Ilgneous/RipWing/ripwing/README.md

# RipWing

Fault-tolerant quadcopter flight controller with edge-deployed anomaly
detection. Firmware in Rust on STM32, scheduled with RTIC. Control logic is
pure and host-testable, validated against a Python simulator before it
reaches hardware.

## Workspace layout

    crates/common     Shared data types. no_std, no HAL. Host + target.
    crates/control    Pure control math (PID, mixer, Controller trait).
                      no_std, host-testable. Depends only on `common`.
    crates/filter     Sensor conditioning: median-of-3 spike rejection into
                      an N-tap moving average. no_std, host-testable.
    crates/estimation Attitude estimation: quaternion complementary filter
                      behind an AttitudeEstimator trait (EKF later).
                      no_std, host-testable.
    crates/safety     Failsafe state machine and safety checks. no_std,
                      host-testable. Depends only on `common`.
    crates/sensors    BMI088, BMP581, MMC5983MA chip drivers on the
                      embedded-hal 1.0 traits. no_std, no HAL, host-tested
                      against register-level fakes.
    firmware          RTIC binary for the STM32F411. Depends on the crates,
                      adds the HAL, drivers, scheduler, and DShot output.

The dependency graph enforces the layering (case study §3.1): `control`
cannot reach a HAL or RTIC type because it does not depend on them, so
"keep control logic host-testable" is a structural fact, not a discipline.

## Build & test

Host-testable control logic (no hardware needed):

    cargo test -p ripwing-control
    cargo test -p ripwing-filter
    cargo test -p ripwing-estimation
    cargo test -p ripwing-safety
    cargo test -p ripwing-sensors
    cargo test -p ripwing-common

Firmware (cross-compiles to ARM; needs the target installed):

    cargo fw          # alias: build -p ripwing-firmware --target thumbv7em-none-eabihf
    cargo rfw         # alias: run   (flash + stream defmt logs) — needs a probe

Toolchain setup:

    rustup target add thumbv7em-none-eabihf
    cargo install probe-rs-tools --locked
    cargo install flip-link

## Target

- Bring-up: STM32F411CEUx (WeAct BlackPill), 25 MHz HSE.
- Planned: STM32H743 (ML compute headroom) on a custom PCB.

## Status

- Scheduler: six-task RTIC graph at rate-monotonic priorities. Done.
- Control crate: two-stage cascade. The outer attitude loop (P per axis,
  shortest-way heading error, rate-demand clamp, tilt-compensated thrust)
  feeds the rate-loop PIDs (anti-windup, derivative-on-measurement
  filtering), then the quad-X mixer (body FLU frame). The firmware runs
  both stages per IMU sample from an `AttitudeSetpoint`, which stays level
  at zero thrust until the RC driver writes it. Heading hold follows the
  estimator's gyro-only yaw, so it drifts with gyro bias until there is a
  magnetometer or EKF. Cross-checked against QuadSim:
  a Rust port of the 10-DOF plant's rotational dynamics matches the Python
  to ~1e-15, and the firmware controller reproduces QuadSim's tuned step
  responses on it, roll, pitch and yaw, at 200 Hz and at the firmware's
  1 kHz, and large steps QuadSim never tested settle without overshoot
  (`crates/control/tests/quadsim_*.rs`). The firmware flies QuadSim's
  tuned gains (`crates/control/src/gains.rs`); a test fails if they drift
  from the tune. Regenerate the reference data with
  `python -m QuadSim.analysis.export_step_references` from the repo root
  after changing the Python plant, controller or gains.
- Safety crate: failsafe state machine (Disarmed/Armed/Failsafe, latched)
  with staleness, attitude, rate and RC-link checks, plus a battery
  monitor; 45 host tests. Wired into the priority-6 task; gates the control
  output.
  - Battery reading: the safety task reads its own ADC (pack voltage
    through the ÷11 divider, ESC current sense), non-blocking at 500 Hz per
    channel, against a VDDA measured at boot.
  - Battery judging: levels use a sag-filtered voltage with a 2 s hold, so
    throttle sag never raises a warning. Cell count is detected at connect,
    and mAh is counted.
  - Battery policy: low battery refuses arming. In flight, Low and Critical
    are warnings only, never a motor cut (there is no auto-land, so a cut
    is a crash).
  - The current sensor's scale in `board.rs` is a placeholder until the
    ESC is chosen.
  - The RC-link input is still a placeholder until that driver exists.
- Filter crate: median-then-average sensor conditioning with documented
  lag-versus-noise tradeoff, plus a noise meter. Wired in at the IMU
  driver boundary (gyro N=2, accel N=8): raw samples are logged, filtered
  samples go downstream.
- IMU: ICM-42688-P on SPI1 with DMA. The control chain is sensor-driven:
  data-ready -> DMA burst read -> fusion -> control, each stage spawned by
  the previous one. Transfers overlap computation. The safety monitor stays
  on SysTick so it can detect a dead sensor chain.
- Estimation crate: quaternion complementary filter (τ = 1 s, accel norm
  gate, seeded from accel at boot) with the magnetometer and barometer
  fused, 40 host tests.
  - Heading: a tilt-compensated magnetometer correction about the world
    vertical only (τ = 5 s), so the magnetometer can never disturb roll or
    pitch. It snaps to the magnetometer once at boot and gates on field
    strength. It applies declination and hard/soft-iron calibration, both
    set in `board.rs`; calibration is not yet measured.
  - Altitude: a third-order complementary filter of baro height and
    world-frame vertical acceleration (τ = 2 s), which learns accel bias.
    It reports height above the boot pressure and climb rate in
    `StateEstimate::vertical`.
  - Each output is withdrawn if its sensor stops for 0.5 s.
- Sensors crate: BMI088 (IMU2), BMP581 baro and MMC5983MA mag drivers on
  embedded-hal 1.0, so they run on the F411 now and the H723 PCB later.
  Host tests run against register-level fakes of each chip. The firmware
  polls them at 500/50/100 Hz, on the PCB's SPI2 and I2C1 pins. Each one is
  optional at boot (probed by chip ID), and a sensor that keeps failing is
  dropped. The magnetometer and barometer feed the estimator.
- Next: bench-verify the IMU path on hardware and measure noise with motors
  spinning; magnetometer hard/soft-iron calibration of the assembled
  airframe; RC driver writing the attitude setpoint, capturing the heading
  at arming, and a rate/acro mode that bypasses the outer loop; EKF.

## Design notes

- Control loop is highest priority after the safety monitor; ML inference
  and telemetry are lower and may be preempted.
- ML monitors and flags; classical control retains flight-critical
  actuation. The severity flag is a single lock-free atomic the control
  loop reads each cycle.
- The Controller trait is the firmware/control seam: swap in an MPC later
  by implementing the trait, without touching the firmware.
