Ilgneous/RipWing/Schematic preview.png

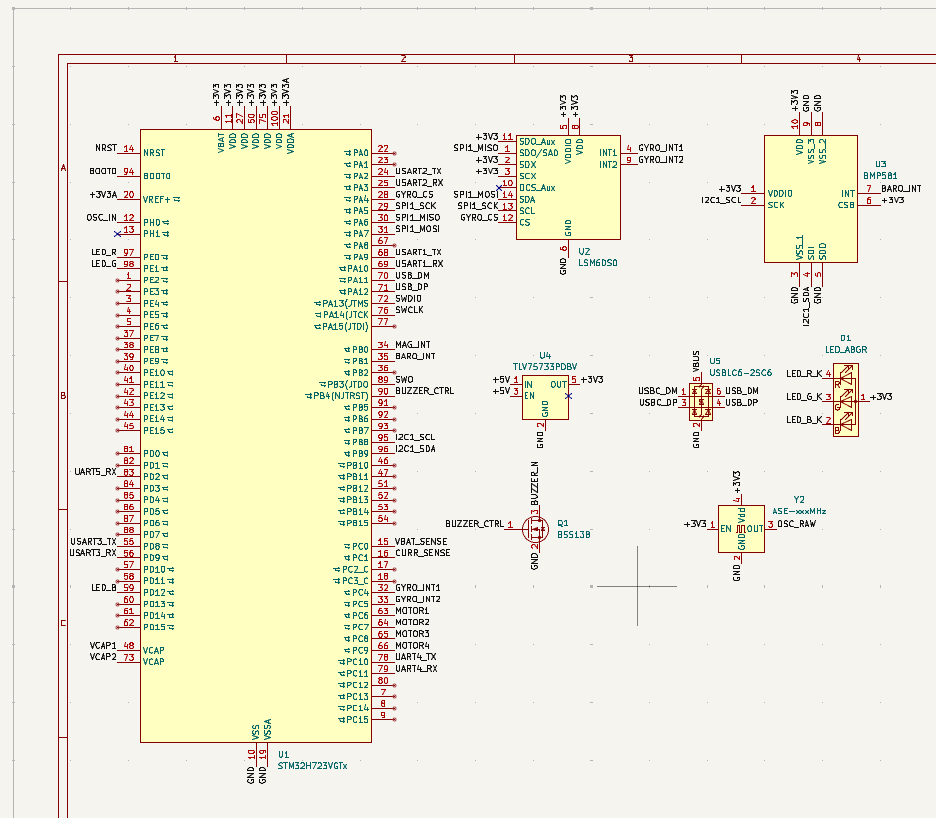
Schematic preview.png
