Ilgneous/RipWing/QuadSim/results/figures/diagnostics.png

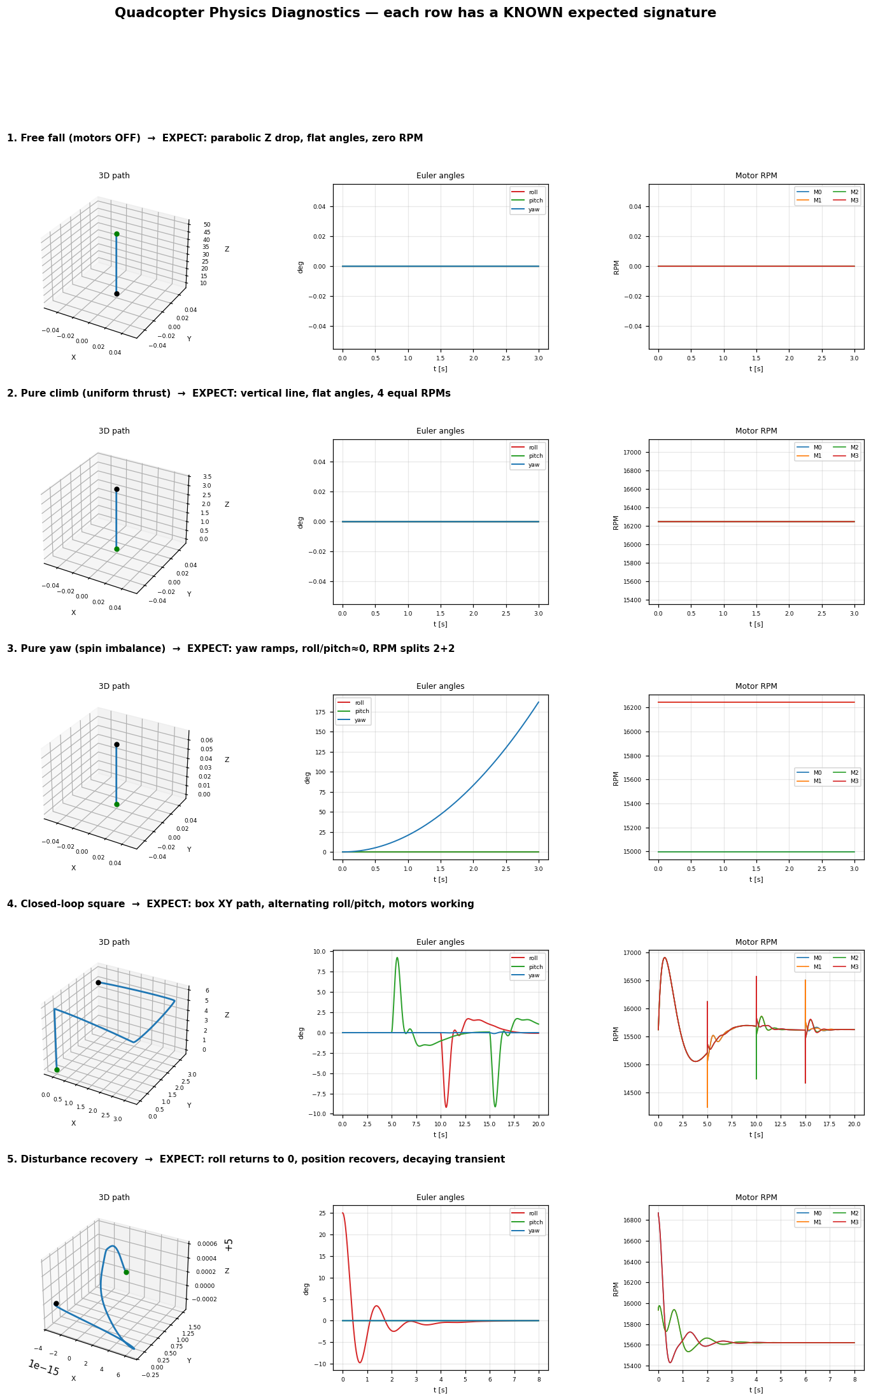
QuadSim/results/figures/diagnostics.png
