Ilgneous/RipWing/QuadSim/results/figures/ground_effect_study.png

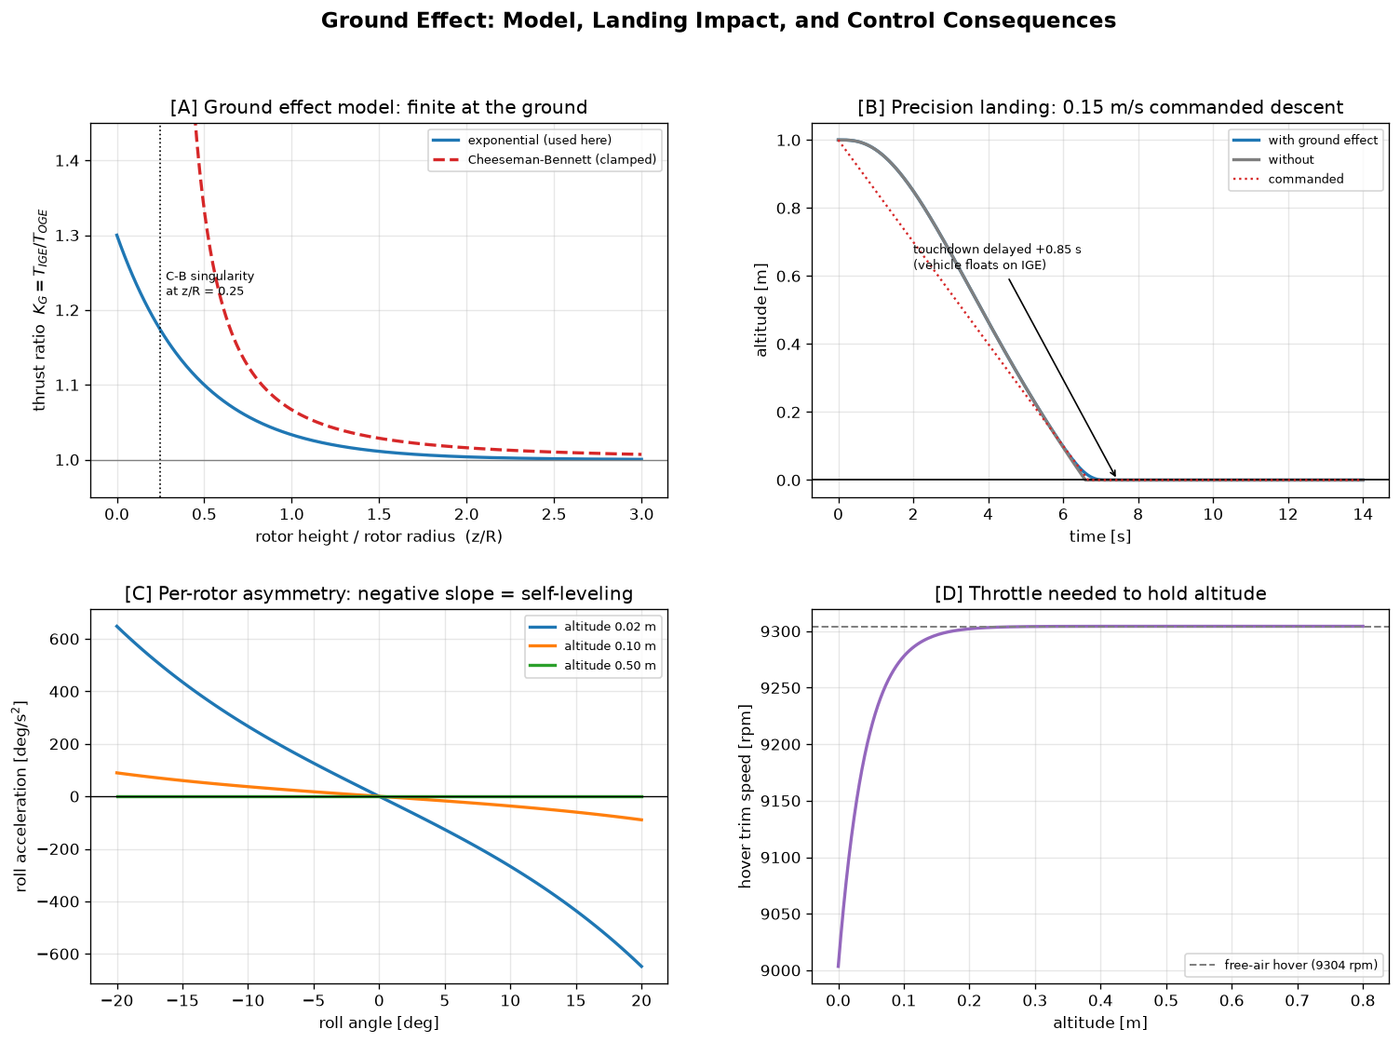
QuadSim/results/figures/ground_effect_study.png
