Ilgneous/RipWing/QuadSim/results/figures/model_comparison.png

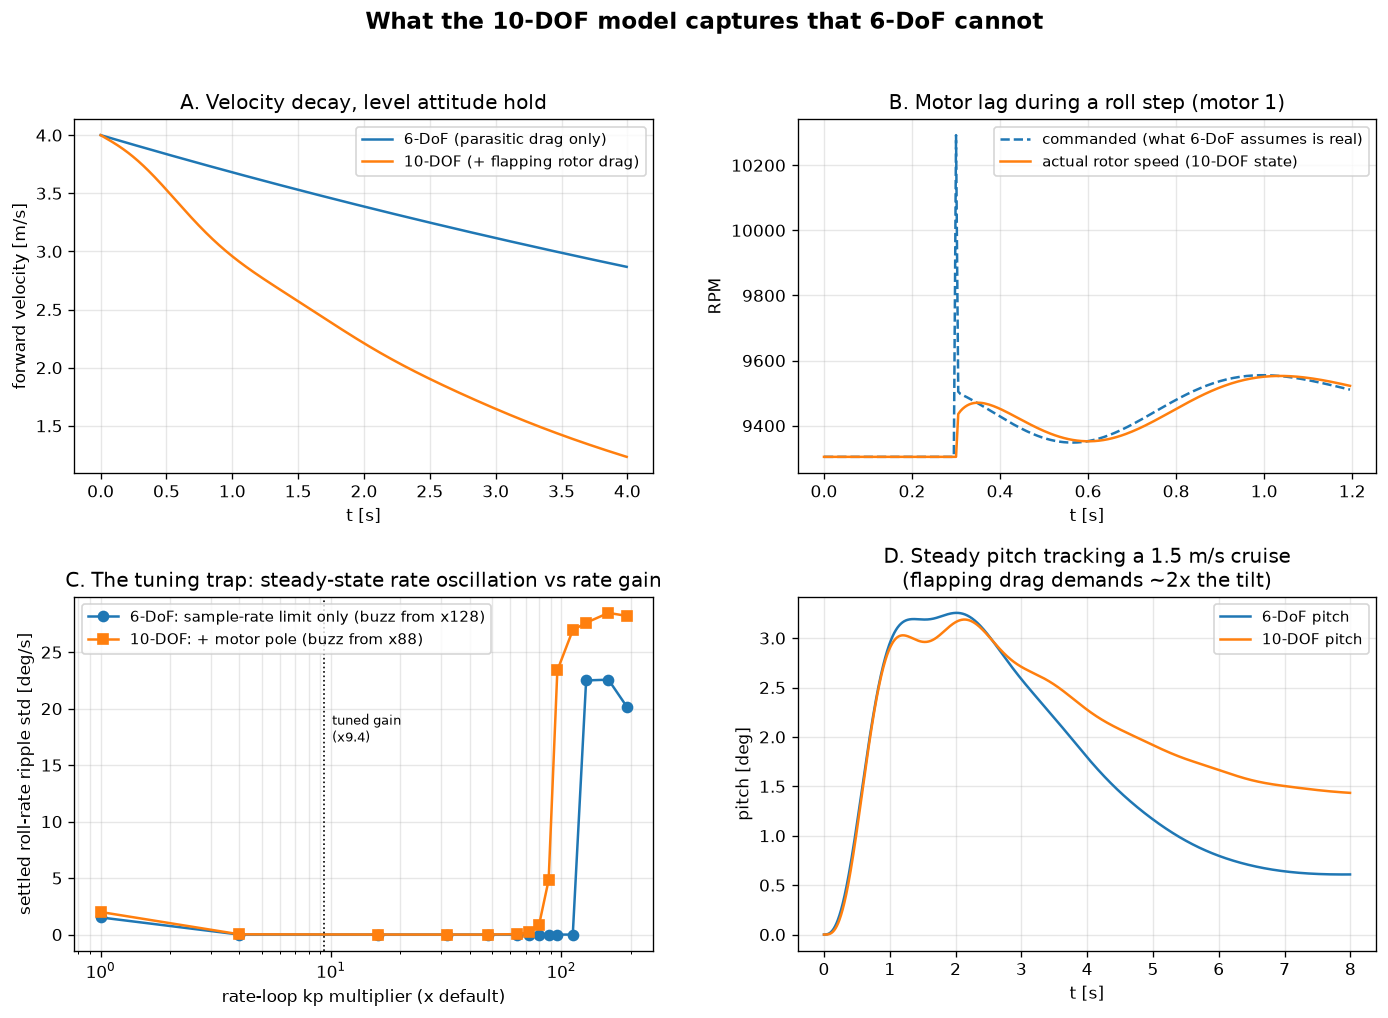
QuadSim/results/figures/model_comparison.png
