Ilgneous/RipWing/QuadSim/results/figures/tuning_comparison.png

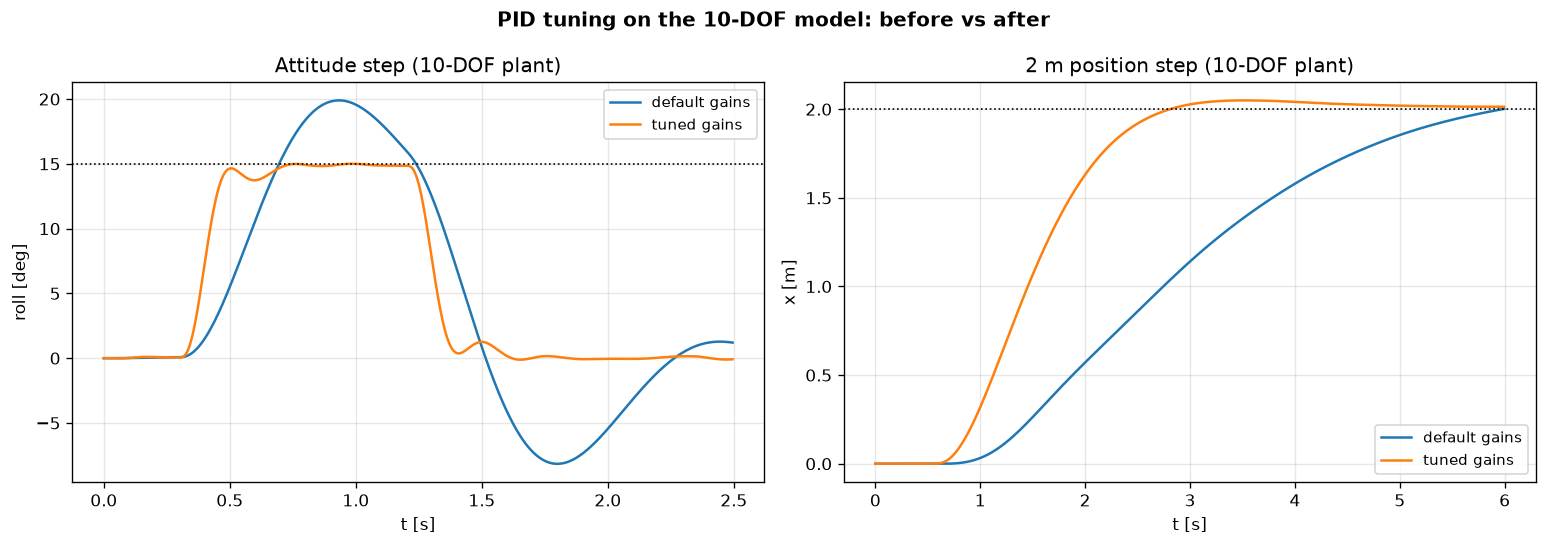
QuadSim/results/figures/tuning_comparison.png
