Ilgneous/RipWing/QuadSim/results/figures/yaw_tuning.png

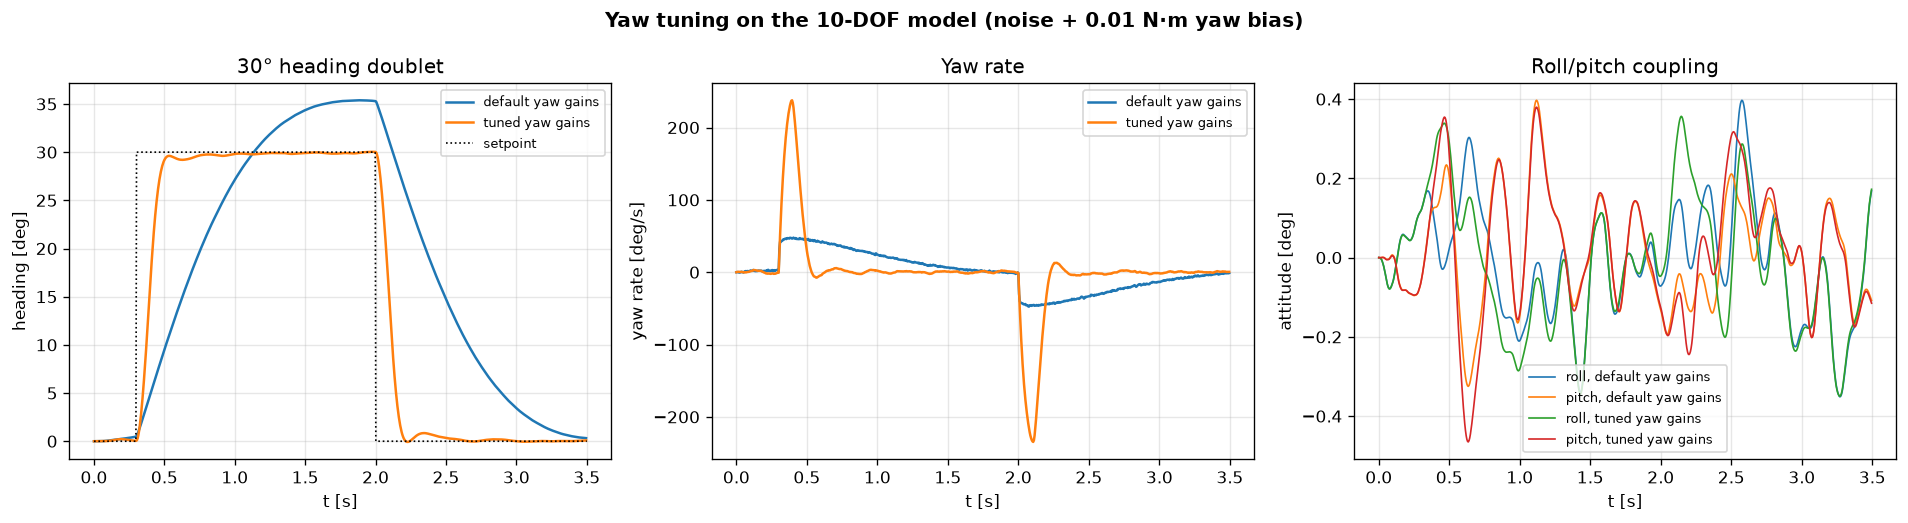
QuadSim/results/figures/yaw_tuning.png
