Ilgneous/RipWing/Ripwing.kicad_sch

## KiCad design Ripwing.kicad_sch (2026-09-10)

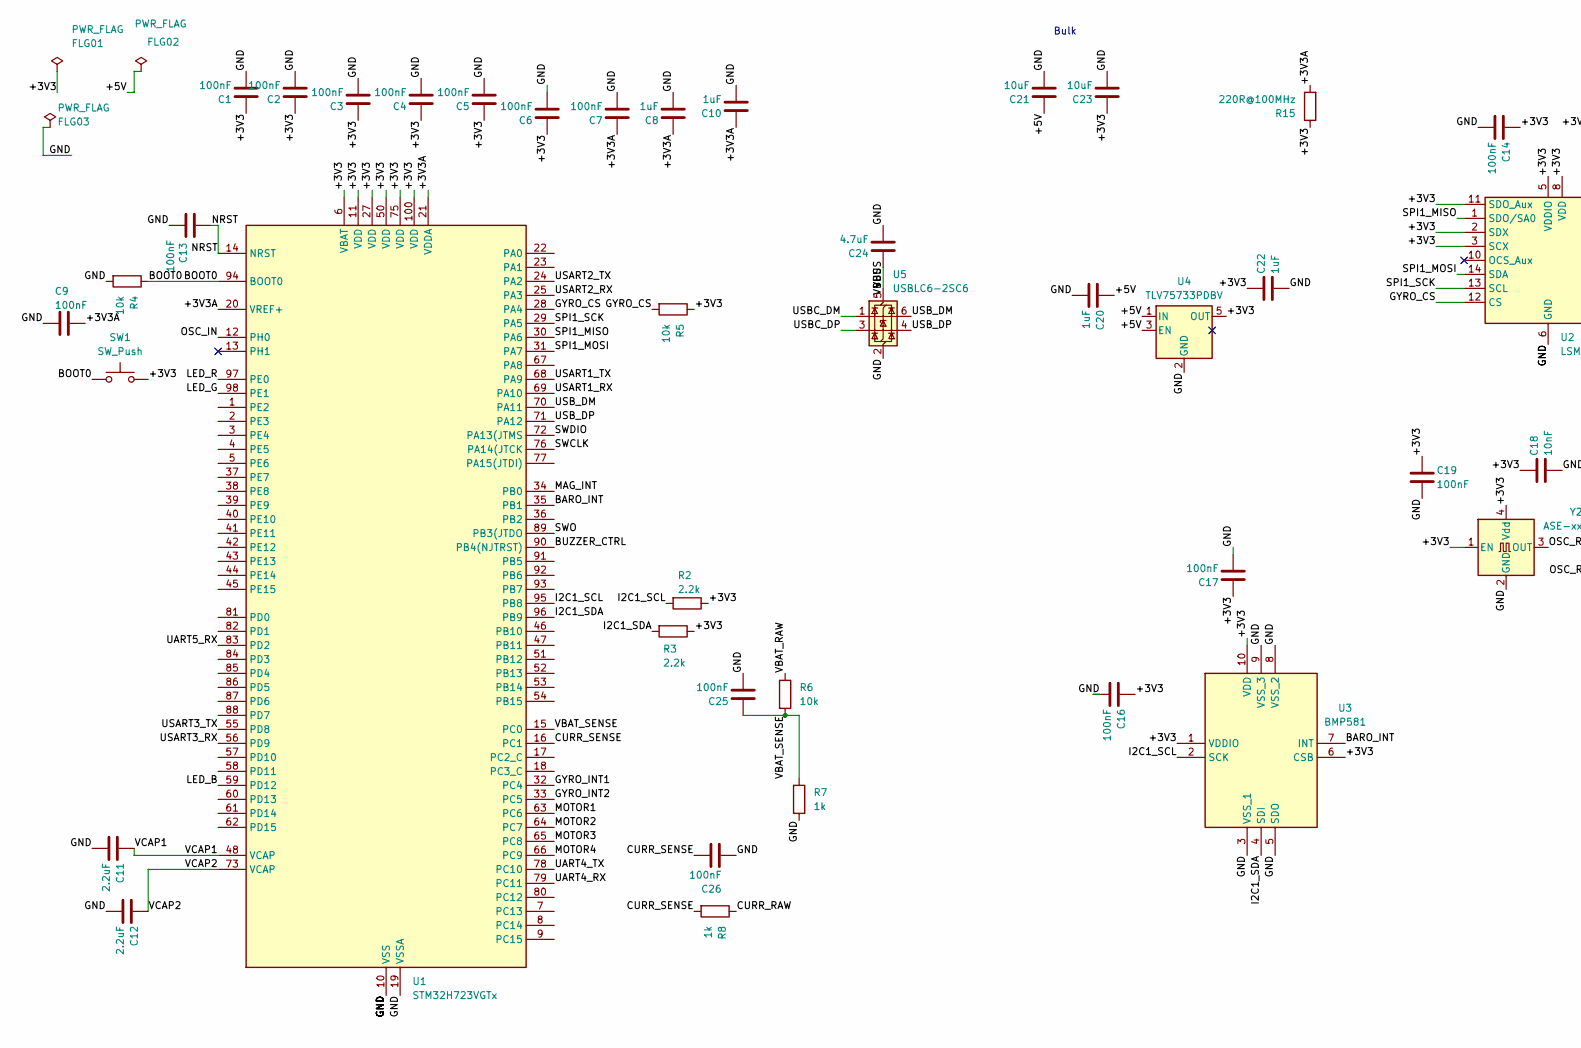
[picture p7: schematic Ripwing.kicad_sch, part in row 1, column 1]

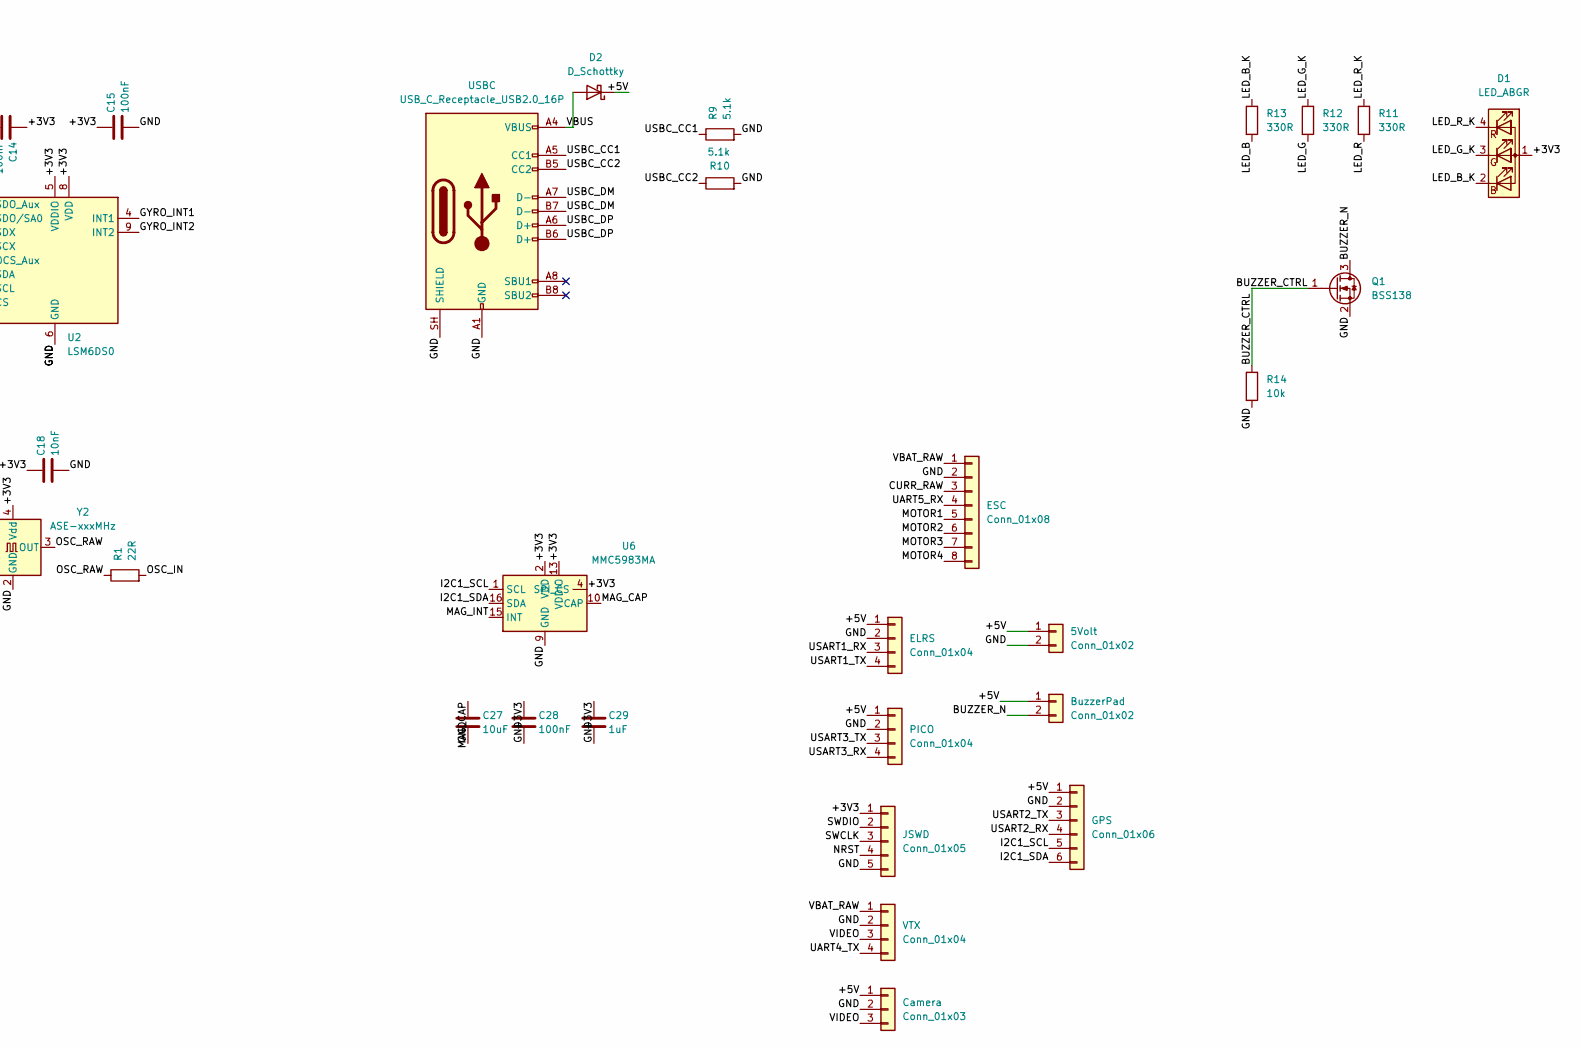
[picture p8: schematic Ripwing.kicad_sch, part in row 1, column 2]

Parts:
5Volt: Conn_01x02
BuzzerPad: Conn_01x02
C1, C2, C3, C4, C5, C6, C7, C9, C13, C14, C15, C16, C17, C19, C25, C26, C28: 100nF
C8, C10, C20, C22, C29: 1uF
C11, C12: 2.2uF
C18: 10nF
C21, C23, C27: 10uF
C24: 4.7uF
Camera: Conn_01x03
D1: LED_ABGR
D2: D_Schottky
ELRS: Conn_01x04
ESC: Conn_01x08
FLG01, FLG02, FLG03: PWR_FLAG
GPS: Conn_01x06
JSWD: Conn_01x05
PICO: Conn_01x04
Q1: BSS138; SOT-23
R1: 22R
R2, R3: 2.2k
R4, R5, R6, R14: 10k
R7, R8: 1k
R9, R10: 5.1k
R11, R12, R13: 330R
R15: 220R@100MHz
SW1: SW_Push
U1: STM32H723VGTx; LQFP-100_14x14mm_P0.5mm
U2: LSM6DS0; LGA-14_3x2.5mm_P0.5mm_LayoutBorder3x4y
U3: BMP581; Mouser Part Number 262-BMP581
U4: TLV75733PDBV; SOT-23-5
U5: USBLC6-2SC6; SOT-23-6
U6: MMC5983MA; LGA-16_3x3mm_P0.5mm
USBC: USB_C_Receptacle_USB2.0_16P
VTX: Conn_01x04
Y2: ASE-xxxMHz; Oscillator_SMD_Abracon_ASE-4Pin_3.2x2.5mm

Connections:
+3V3: C1.1, C2.1, C3.1, C4.1, C5.1, C6.1, C14.1, C15.1, C16.1, C17.1, C18.1, C19.1, C22.1, C23.1, C28.1, C29.1, D1.1 (A), FLG01.1, JSWD.1, R2.1, R3.1, R5.1, R15.1, SW1.2, U1.6 (VBAT), U1.11 (VDD), U1.27 (VDD), U1.50 (VDD), U1.75 (VDD), U1.100 (VDD), U2.2 (SDX), U2.3 (SCX), U2.5 (VDDIO), U2.8 (VDD), U2.11 (SDO_Aux), U3.1 (VDDIO), U3.6 (CSB), U3.10 (VDD), U4.5 (OUT), U6.2 (VDD), U6.4 (SPI_CS), U6.13 (VDDIO), Y2.1 (EN), Y2.4 (Vdd)
+3V3A: C7.1, C8.1, C9.1, C10.1, R15.2, U1.20 (VREF+), U1.21 (VDDA)
+5V: 5Volt.1, BuzzerPad.1, C20.1, C21.1, Camera.1, D2.1 (K), ELRS.1, FLG02.1, GPS.1, PICO.1, U4.1 (IN), U4.3 (EN)
BARO_INT: U1.35 (PB1), U3.7 (INT)
BOOT0: R4.1, SW1.1, U1.94 (BOOT0)
BUZZER_CTRL: Q1.1 (G), R14.1, U1.90 (PB4(NJTRST))
BUZZER_N: BuzzerPad.2, Q1.3 (D)
CURR_RAW: ESC.3, R8.1
CURR_SENSE: C26.1, R8.2, U1.16 (PC1)
GND: 5Volt.2, C1.2, C2.2, C3.2, C4.2, C5.2, C6.2, C7.2, C8.2, C9.2, C10.2, C11.2, C12.2, C13.2, C14.2, C15.2, C16.2, C17.2, C18.2, C19.2, C20.2, C21.2, C22.2, C23.2, C24.2, C25.2, C26.2, C27.2, C28.2, C29.2, Camera.2, ELRS.2, ESC.2, FLG03.1, GPS.2, JSWD.5, PICO.2, Q1.2 (S), R4.2, R7.2, R9.2, R10.2, R14.2, U1.10 (VSS), U1.19 (VSSA), U1.26 (VSS), U1.49 (VSS), U1.74 (VSS), U1.99 (VSS), U2.6 (GND), U2.7 (GND), U3.3 (VSS_1), U3.5 (SDO), U3.8 (VSS_2), U3.9 (VSS_3), U4.2 (GND), U5.2 (GND), U6.9 (GND), U6.11 (GND), USBC.A1 (GND), USBC.A12 (GND), USBC.B1 (GND), USBC.B12 (GND), USBC.SH (SHIELD), VTX.2, Y2.2 (GND)
GYRO_CS: R5.2, U1.28 (PA4), U2.12 (CS)
GYRO_INT1: U1.32 (PC4), U2.4 (INT1)
GYRO_INT2: U1.33 (PC5), U2.9 (INT2)
I2C1_SCL: GPS.5, R2.2, U1.95 (PB8), U3.2 (SCK), U6.1 (SCL)
I2C1_SDA: GPS.6, R3.2, U1.96 (PB9), U3.4 (SDI), U6.16 (SDA)
LED_B: R13.2, U1.59 (PD12)
LED_B_K: D1.2 (BK), R13.1
LED_G: R12.2, U1.98 (PE1)
LED_G_K: D1.3 (GK), R12.1
LED_R: R11.2, U1.97 (PE0)
LED_R_K: D1.4 (RK), R11.1
MAG_CAP: C27.1, U6.10 (CAP)
MAG_INT: U1.34 (PB0), U6.15 (INT)
MOTOR1: ESC.5, U1.63 (PC6)
MOTOR2: ESC.6, U1.64 (PC7)
MOTOR3: ESC.7, U1.65 (PC8)
MOTOR4: ESC.8, U1.66 (PC9)
NRST: C13.1, JSWD.4, U1.14 (NRST)
OSC_IN: R1.2, U1.12 (PH0)
OSC_RAW: R1.1, Y2.3 (OUT)
SPI1_MISO: U1.30 (PA6), U2.1 (SDO/SA0)
SPI1_MOSI: U1.31 (PA7), U2.14 (SDA)
SPI1_SCK: U1.29 (PA5), U2.13 (SCL)
SWCLK: JSWD.3, U1.76 (PA14(JTCK)
SWDIO: JSWD.2, U1.72 (PA13(JTMS)
SWO: U1.89 (PB3(JTDO)
UART4_RX: U1.79 (PC11)
UART4_TX: U1.78 (PC10), VTX.4
UART5_RX: ESC.4, U1.83 (PD2)
USART1_RX: ELRS.3, U1.69 (PA10)
USART1_TX: ELRS.4, U1.68 (PA9)
USART2_RX: GPS.4, U1.25 (PA3)
USART2_TX: GPS.3, U1.24 (PA2)
USART3_RX: PICO.4, U1.56 (PD9)
USART3_TX: PICO.3, U1.55 (PD8)
USBC_CC1: R9.1, USBC.A5 (CC1)
USBC_CC2: R10.1, USBC.B5 (CC2)
USBC_DM: U5.1 (I/O1), USBC.A7 (D-), USBC.B7 (D-)
USBC_DP: U5.3 (I/O2), USBC.A6 (D+), USBC.B6 (D+)
USB_DM: U1.70 (PA11), U5.6 (I/O1)
USB_DP: U1.71 (PA12), U5.4 (I/O2)
VBAT_RAW: ESC.1, R6.1, VTX.1
VBAT_SENSE: C25.1, R6.2, R7.1, U1.15 (PC0)
VBUS: C24.1, D2.2 (A), U5.5 (VBUS), USBC.A4 (VBUS), USBC.A9 (VBUS), USBC.B4 (VBUS), USBC.B9 (VBUS)
VCAP1: C11.1, U1.48 (VCAP)
VCAP2: C12.1, U1.73 (VCAP)
VIDEO: Camera.3, VTX.3

Notes on the sheet:
Bulk
