Ilgneous/RipWing/Hardware/RipWing/Ripwing/Ripwing.kicad_sch

## KiCad design Hardware/RipWing/Ripwing/Ripwing.kicad_sch (2026-11-09)

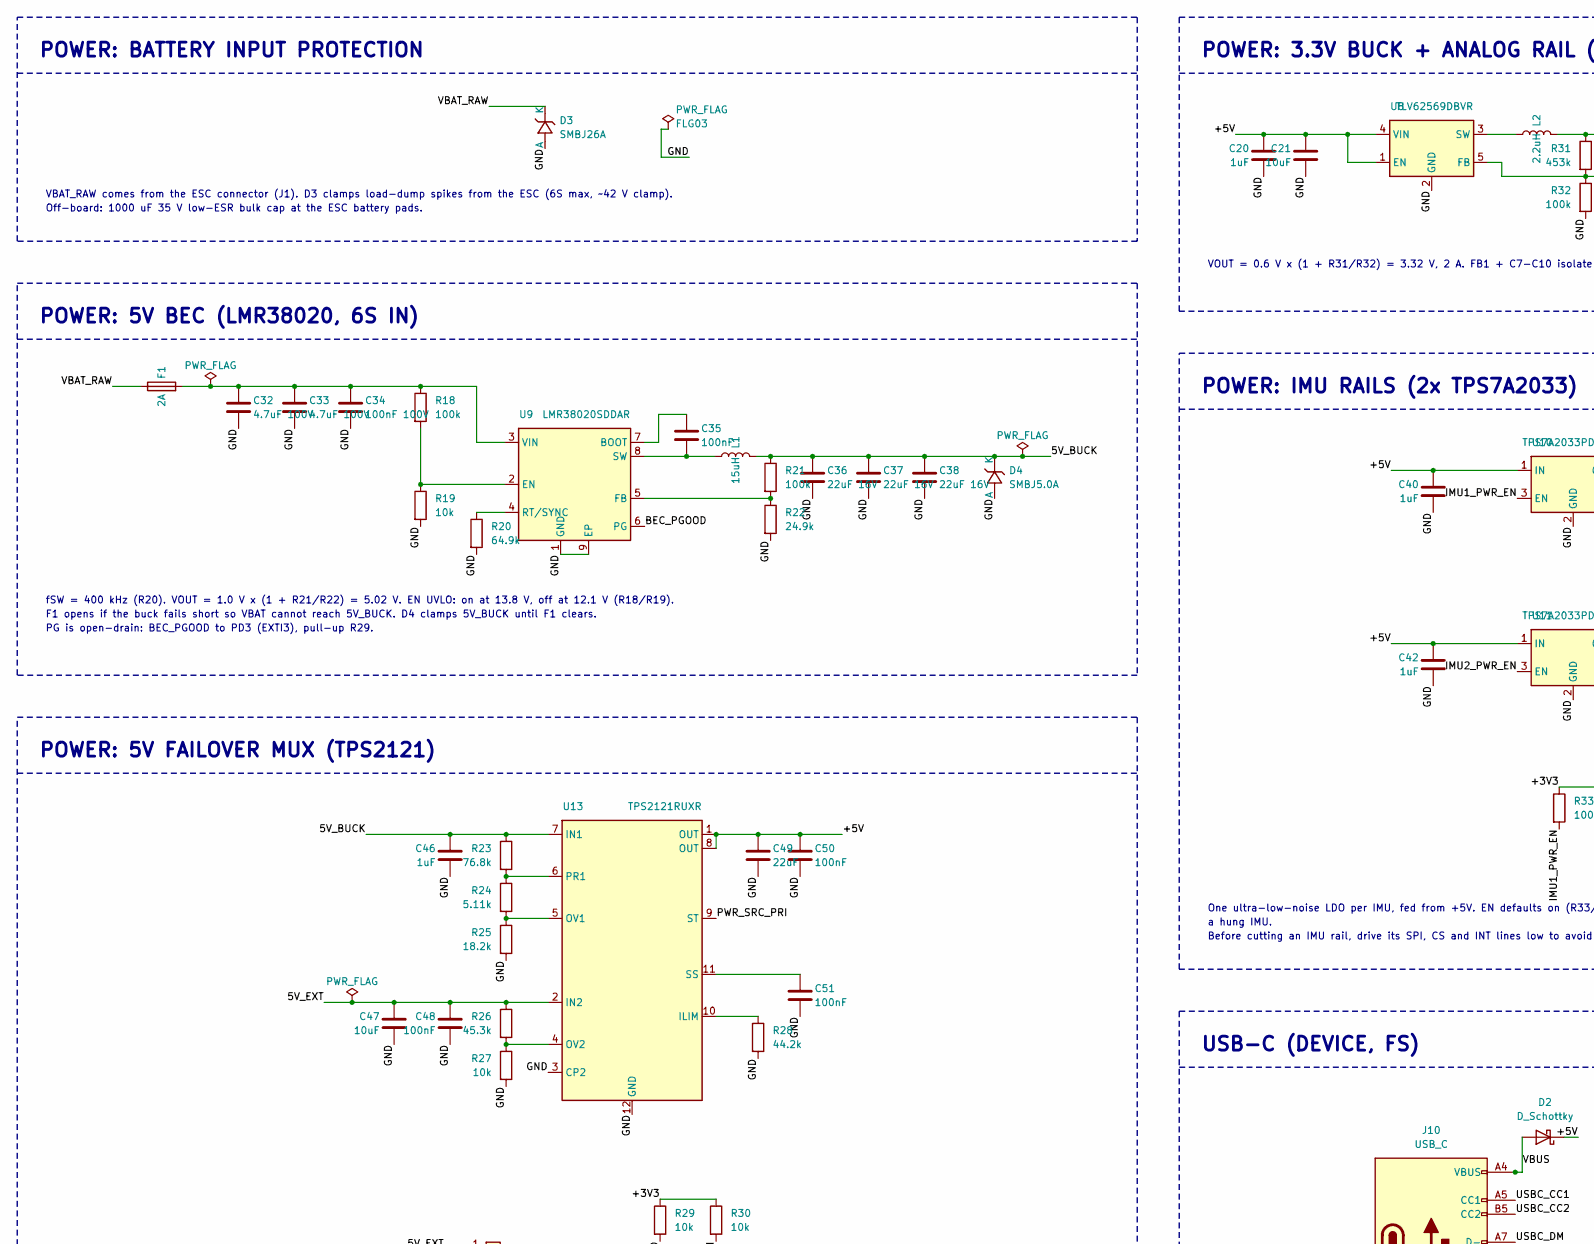
[picture p9: schematic Ripwing.kicad_sch, part in row 1, column 1]

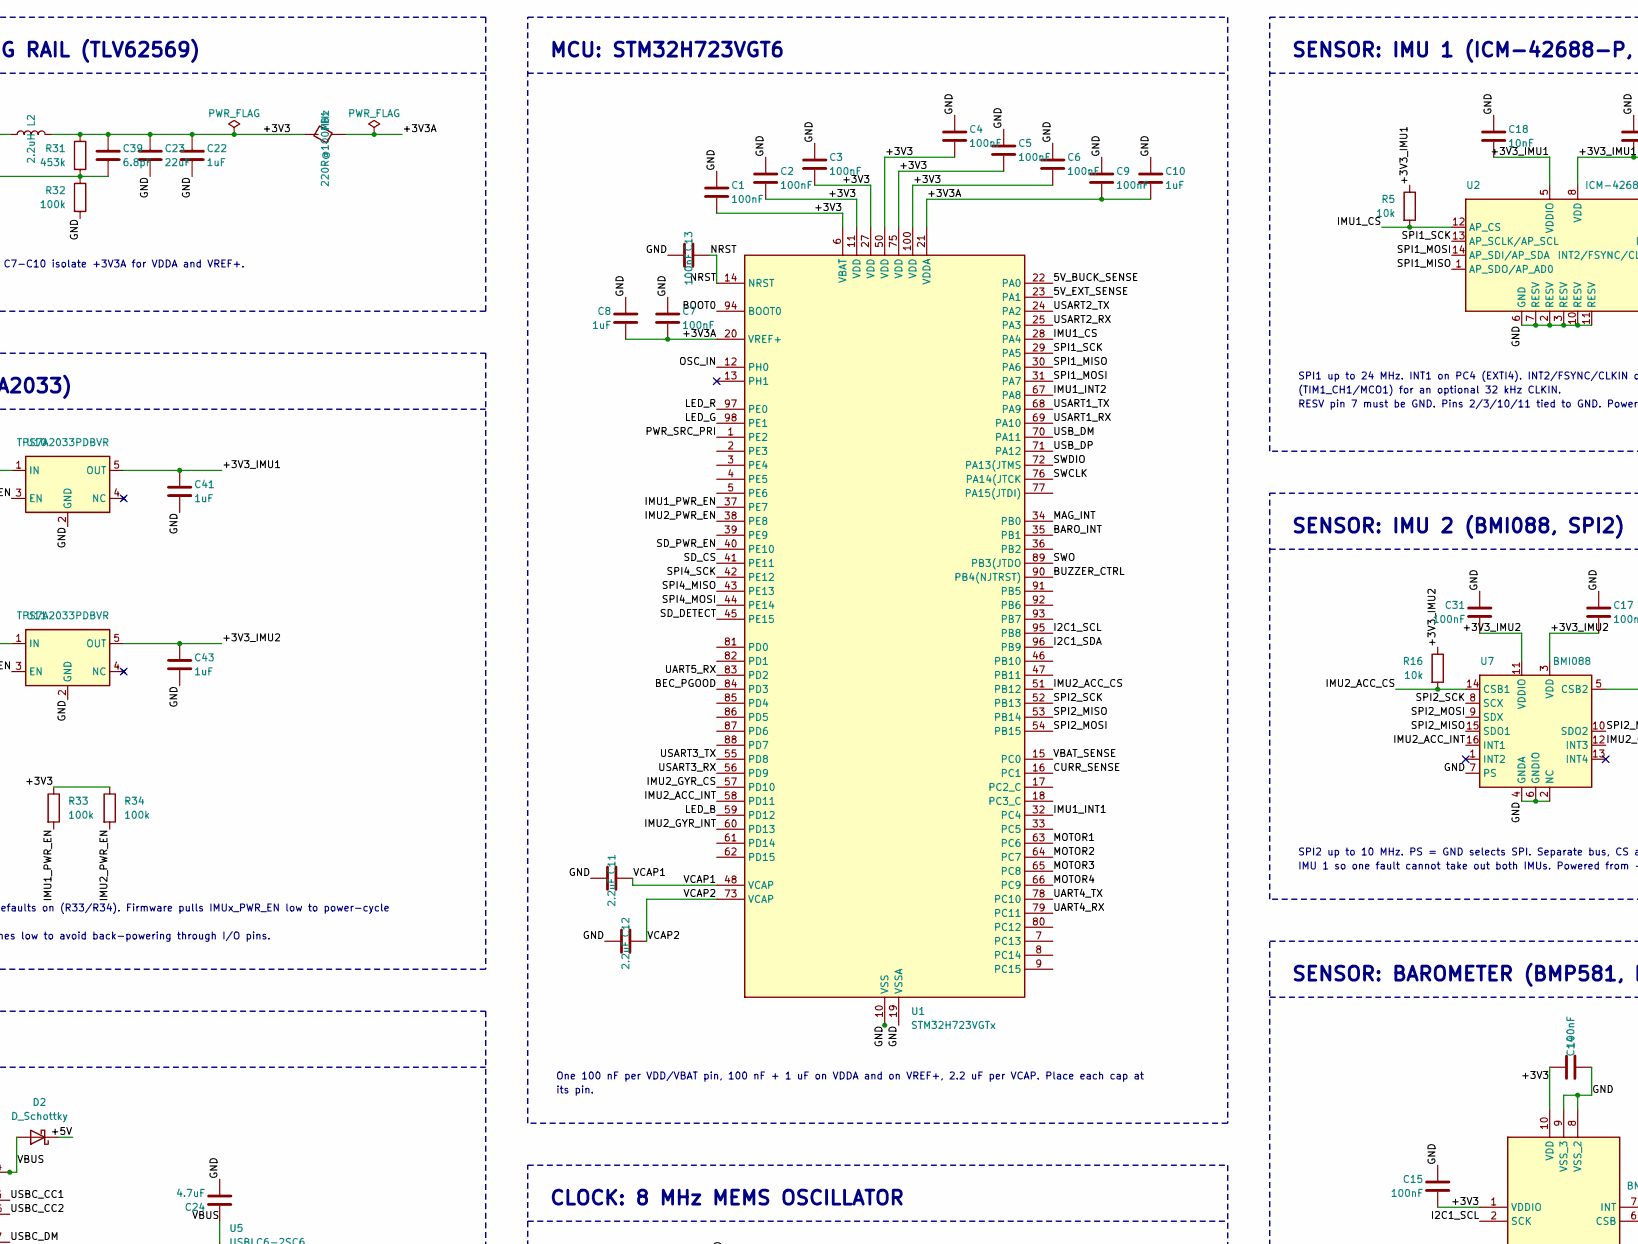
[picture p10: schematic Ripwing.kicad_sch, part in row 1, column 2]

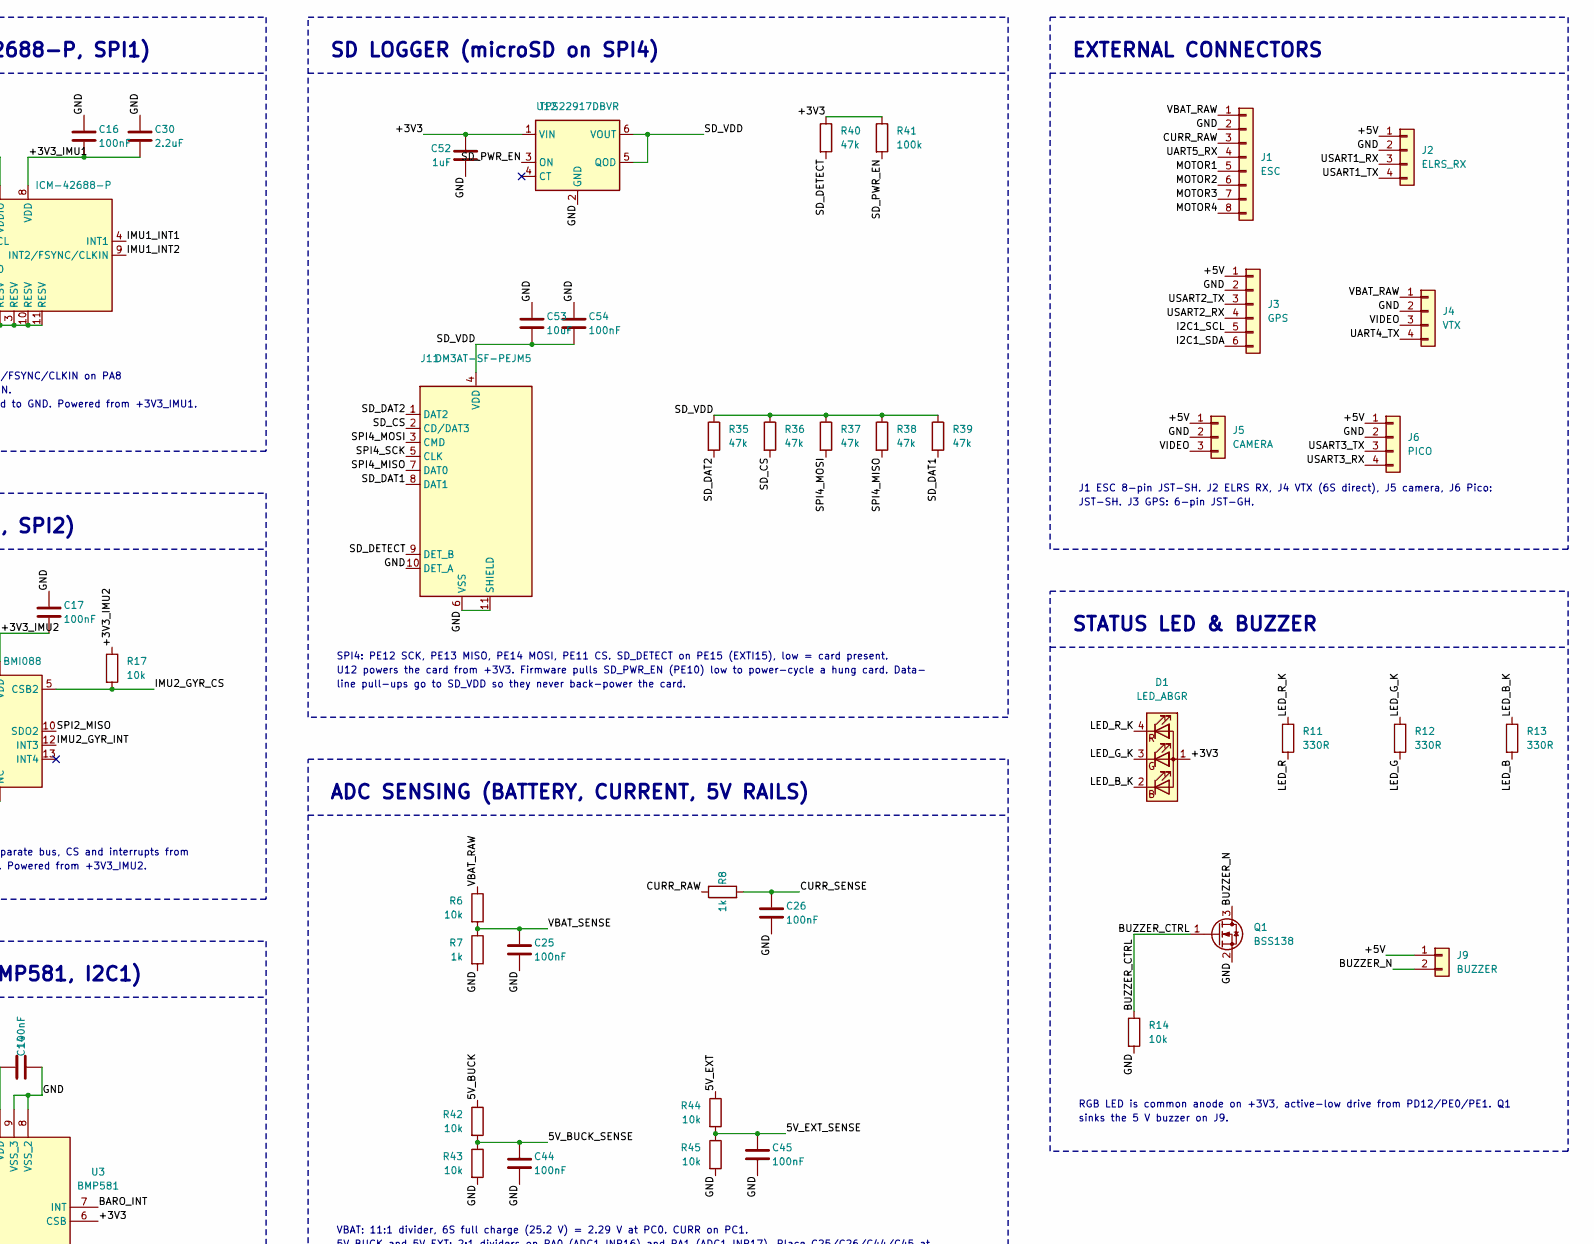
[picture p11: schematic Ripwing.kicad_sch, part in row 1, column 3]

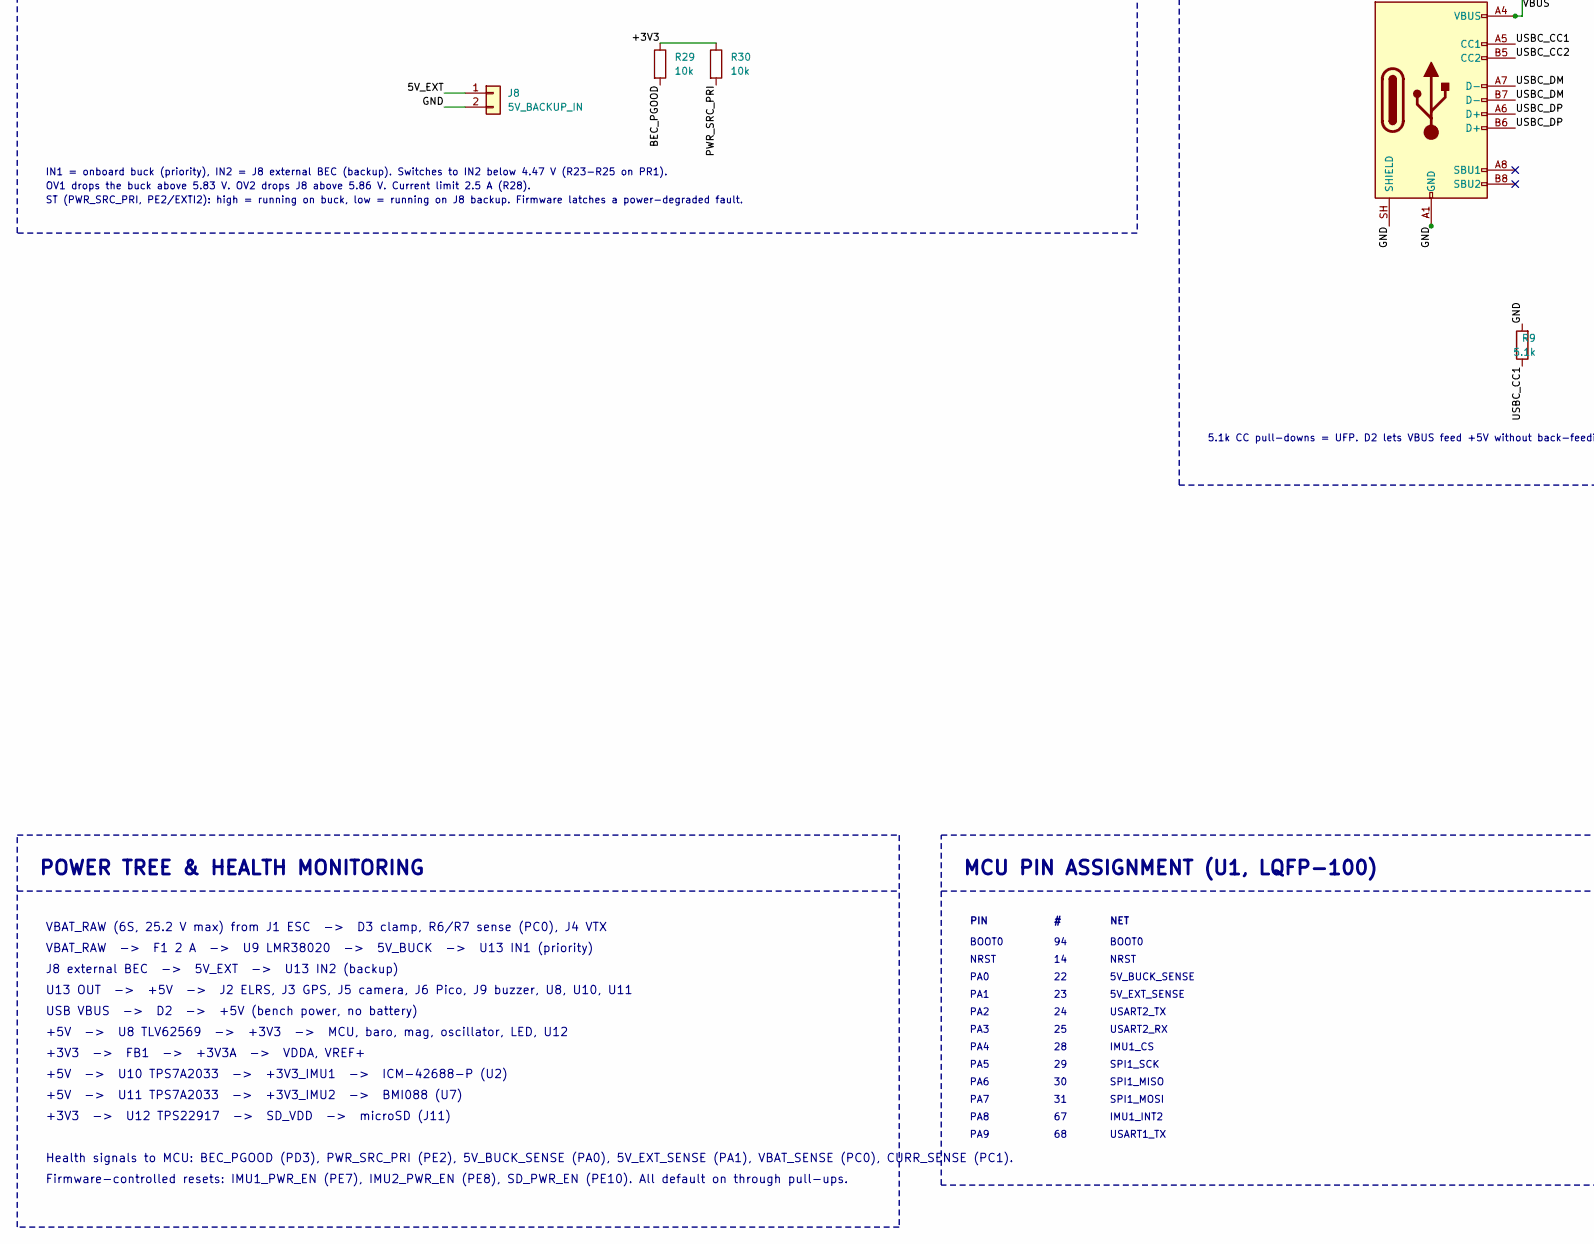
[picture p12: schematic Ripwing.kicad_sch, part in row 2, column 1]

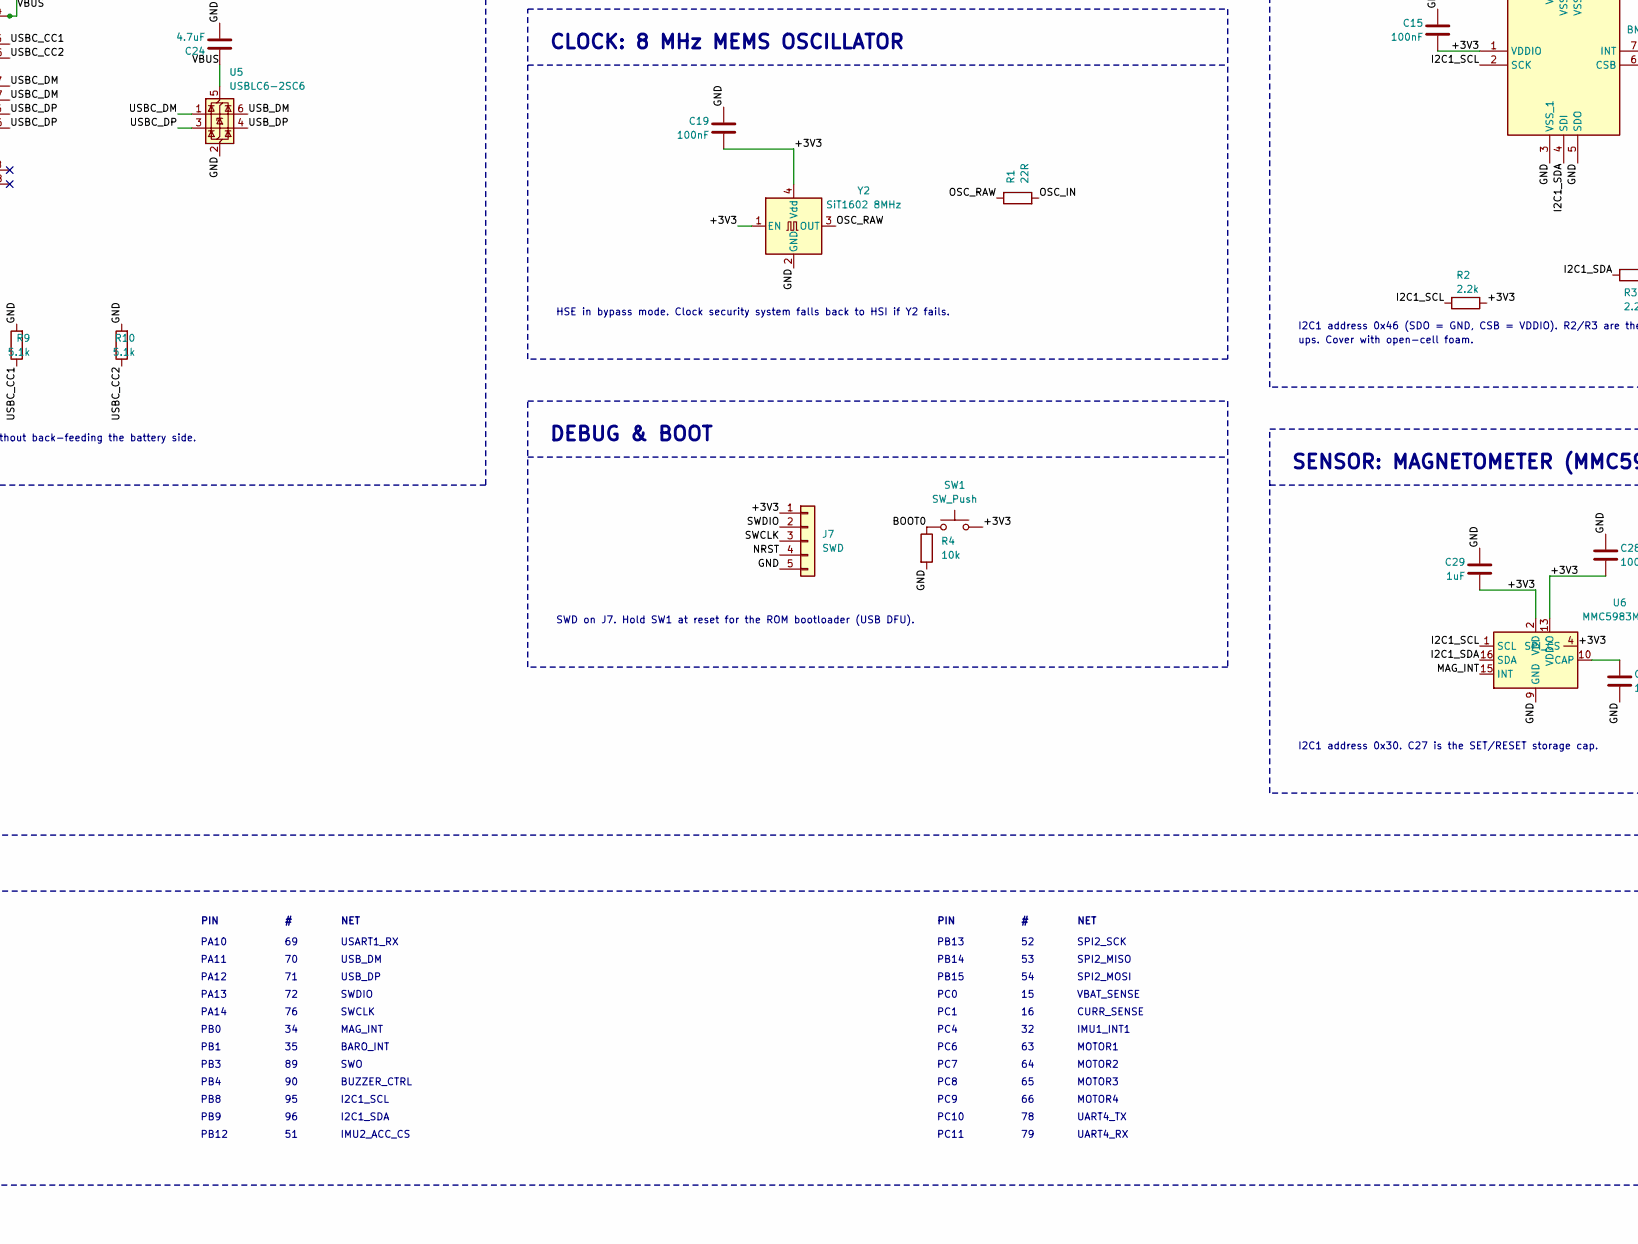
[picture p13: schematic Ripwing.kicad_sch, part in row 2, column 2]

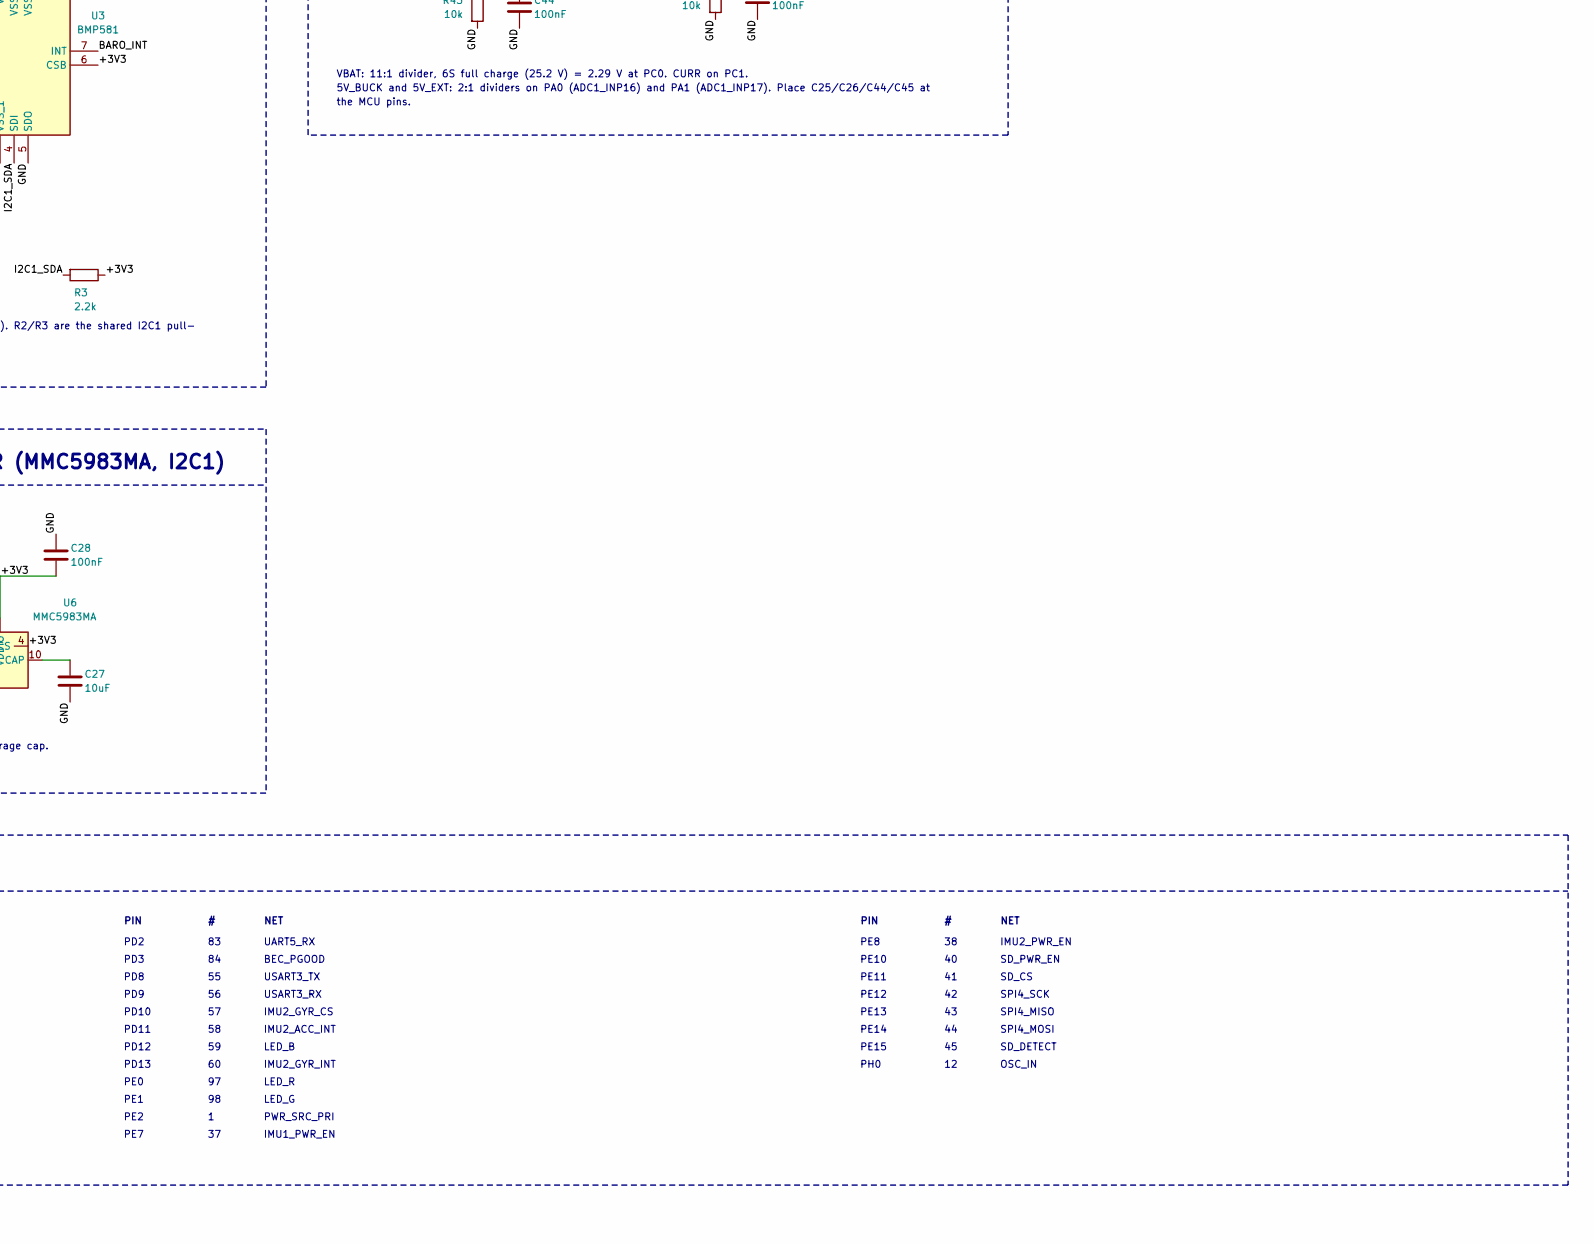
[picture p14: schematic Ripwing.kicad_sch, part in row 2, column 3]

Parts:
C1, C2, C3, C4, C5, C6, C7, C9, C13, C14, C15, C16, C17, C19, C25, C26, C28, C31, C35, C44, C45, C48, C50, C51, C54: 100nF; C_0402_1005Metric
C8, C10, C20, C22, C29, C40, C41, C42, C43, C46, C52: 1uF; C_0402_1005Metric
C11, C12, C30: 2.2uF; C_0603_1608Metric
C18: 10nF; C_0402_1005Metric
C21, C27, C47, C53: 10uF; C_0805_2012Metric
C23, C49: 22uF; C_0805_2012Metric
C24: 4.7uF; C_0603_1608Metric
C32, C33: 4.7uF 100V; C_1206_3216Metric
C34: 100nF 100V; C_0603_1608Metric
C36, C37, C38: 22uF 16V; C_1206_3216Metric
C39: 6.8pF; C_0402_1005Metric
D1: LED_ABGR
D2: D_Schottky
D3: SMBJ26A; D_SMB
D4: SMBJ5.0A; D_SMB
F1: 2A; Fuse_1206_3216Metric
FB1: 220R@100MHz; L_0402_1005Metric
FLG01, FLG03, FLG04, FLG05, FLG06, FLG07: PWR_FLAG
J1: ESC
J2: ELRS_RX
J3: GPS
J4: VTX
J5: CAMERA
J6: PICO
J7: SWD
J8: 5V_BACKUP_IN
J9: BUZZER
J10: USB_C
J11: DM3AT-SF-PEJM5; microSD_HC_Hirose_DM3AT-SF-PEJM5
L1: 15uH
L2: 2.2uH
Q1: BSS138; SOT-23
R1: 22R; R_0402_1005Metric
R2, R3: 2.2k; R_0402_1005Metric
R4, R5, R6, R14, R16, R17, R19, R27, R29, R30, R42, R43, R44, R45: 10k; R_0402_1005Metric
R7, R8: 1k; R_0402_1005Metric
R9, R10: 5.1k; R_0402_1005Metric
R11, R12, R13: 330R; R_0402_1005Metric
R18, R21, R32, R33, R34, R41: 100k; R_0402_1005Metric
R20: 64.9k; R_0402_1005Metric
R22: 24.9k; R_0402_1005Metric
R23: 76.8k; R_0402_1005Metric
R24: 5.11k; R_0402_1005Metric
R25: 18.2k; R_0402_1005Metric
R26: 45.3k; R_0402_1005Metric
R28: 44.2k; R_0402_1005Metric
R31: 453k; R_0402_1005Metric
R35, R36, R37, R38, R39, R40: 47k; R_0402_1005Metric
SW1: SW_Push
U1: STM32H723VGTx; LQFP-100_14x14mm_P0.5mm
U2: ICM-42688-P; LGA-14_3x2.5mm_P0.5mm_LayoutBorder3x4y
U3: BMP581; Mouser Part Number 262-BMP581
U5: USBLC6-2SC6; SOT-23-6
U6: MMC5983MA; LGA-16_3x3mm_P0.5mm
U7: BMI088
U8: TLV62569DBVR
U9: LMR38020SDDAR
U10, U11: TPS7A2033PDBVR
U12: TPS22917DBVR
U13: TPS2121RUXR
Y2: SiT1602 8MHz; Oscillator_SMD_Abracon_ASE-4Pin_3.2x2.5mm

Connections:
5V_BUCK: C36.1, C37.1, C38.1, C46.1, D4.1 (K), FLG07.1, L1.2, R21.1, R23.1, R42.1, U13.7 (IN1)
5V_BUCK_SENSE: C44.1, R42.2, R43.1, U1.22 (PA0)
5V_EXT: C47.1, C48.1, FLG06.1, J8.1, R26.1, R44.1, U13.2 (IN2)
5V_EXT_SENSE: C45.1, R44.2, R45.1, U1.23 (PA1)
+3V3: C1.2, C2.2, C3.2, C4.2, C5.2, C6.2, C14.1, C15.2, C19.2, C22.1, C23.1, C28.2, C29.2, C39.1, C52.1, D1.1 (A), FB1.1, FLG01.1, J7.1, L2.2, R2.1, R3.1, R29.1, R30.1, R31.1, R33.1, R34.1, R40.1, R41.1, SW1.2, U1.6 (VBAT), U1.11 (VDD), U1.27 (VDD), U1.50 (VDD), U1.75 (VDD), U1.100 (VDD), U3.1 (VDDIO), U3.6 (CSB), U3.10 (VDD), U6.2 (VDD), U6.4 (SPI_CS), U6.13 (VDDIO), U12.1 (VIN), Y2.1 (EN), Y2.4 (Vdd)
+3V3A: C7.2, C8.2, C9.2, C10.2, FB1.2, FLG04.1, U1.20 (VREF+), U1.21 (VDDA)
+3V3_IMU1: C16.2, C18.2, C30.2, C41.1, R5.1, U2.5 (VDDIO), U2.8 (VDD), U10.5 (OUT)
+3V3_IMU2: C17.2, C31.2, C43.1, R16.1, R17.1, U7.3 (VDD), U7.11 (VDDIO), U11.5 (OUT)
+5V: C20.1, C21.1, C40.1, C42.1, C49.1, C50.1, D2.1 (K), J2.1, J3.1, J5.1, J6.1, J9.1, U8.1 (EN), U8.4 (VIN), U10.1 (IN), U11.1 (IN), U13.1 (OUT), U13.8 (OUT)
BARO_INT: U1.35 (PB1), U3.7 (INT)
BEC_PGOOD: R29.2, U1.84 (PD3), U9.6 (PG)
BOOT0: R4.1, SW1.1, U1.94 (BOOT0)
BUZZER_CTRL: Q1.1 (G), R14.1, U1.90 (PB4(NJTRST))
BUZZER_N: J9.2, Q1.3 (D)
CURR_RAW: J1.3, R8.1
CURR_SENSE: C26.1, R8.2, U1.16 (PC1)
GND: C1.1, C2.1, C3.1, C4.1, C5.1, C6.1, C7.1, C8.1, C9.1, C10.1, C11.2, C12.2, C13.2, C14.2, C15.1, C16.1, C17.1, C18.1, C19.1, C20.2, C21.2, C22.2, C23.2, C24.2, C25.2, C26.2, C27.2, C28.1, C29.1, C30.1, C31.1, C32.2, C33.2, C34.2, C36.2, C37.2, C38.2, C40.2, C41.2, C42.2, C43.2, C44.2, C45.2, C46.2, C47.2, C48.2, C49.2, C50.2, C51.2, C52.2, C53.1, C54.1, D3.2 (A), D4.2 (A), FLG03.1, J1.2, J2.2, J3.2, J4.2, J5.2, J6.2, J7.5, J8.2, J10.A1 (GND), J10.A12 (GND), J10.B1 (GND), J10.B12 (GND), J10.SH (SHIELD), J11.6 (VSS), J11.10 (DET_A), J11.11 (SHIELD), Q1.2 (S), R4.2, R7.2, R9.2, R10.2, R14.2, R19.2, R20.2, R22.2, R25.2, R27.2, R28.2, R32.2, R43.2, R45.2, U1.10 (VSS), U1.19 (VSSA), U1.26 (VSS), U1.49 (VSS), U1.74 (VSS), U1.99 (VSS), U2.2 (RESV), U2.3 (RESV), U2.6 (GND), U2.7 (RESV), U2.10 (RESV), U2.11 (RESV), U3.3 (VSS_1), U3.5 (SDO), U3.8 (VSS_2), U3.9 (VSS_3), U5.2 (GND), U6.9 (GND), U6.11 (GND), U7.2 (NC), U7.4 (GNDA), U7.6 (GNDIO), U7.7 (PS), U8.2 (GND), U9.1 (GND), U9.9 (EP), U10.2 (GND), U11.2 (GND), U12.2 (GND), U13.3 (CP2), U13.12 (GND), Y2.2 (GND)
I2C1_SCL: J3.5, R2.2, U1.95 (PB8), U3.2 (SCK), U6.1 (SCL)
I2C1_SDA: J3.6, R3.2, U1.96 (PB9), U3.4 (SDI), U6.16 (SDA)
IMU1_CS: R5.2, U1.28 (PA4), U2.12 (AP_CS)
IMU1_INT1: U1.32 (PC4), U2.4 (INT1)
IMU1_INT2: U1.67 (PA8), U2.9 (INT2/FSYNC/CLKIN)
IMU1_PWR_EN: R33.2, U1.37 (PE7), U10.3 (EN)
IMU2_ACC_CS: R16.2, U1.51 (PB12), U7.14 (CSB1)
IMU2_ACC_INT: U1.58 (PD11), U7.16 (INT1)
IMU2_GYR_CS: R17.2, U1.57 (PD10), U7.5 (CSB2)
IMU2_GYR_INT: U1.60 (PD13), U7.12 (INT3)
IMU2_PWR_EN: R34.2, U1.38 (PE8), U11.3 (EN)
LED_B: R13.2, U1.59 (PD12)
LED_B_K: D1.2 (BK), R13.1
LED_G: R12.2, U1.98 (PE1)
LED_G_K: D1.3 (GK), R12.1
LED_R: R11.2, U1.97 (PE0)
LED_R_K: D1.4 (RK), R11.1
MAG_INT: U1.34 (PB0), U6.15 (INT)
MOTOR1: J1.5, U1.63 (PC6)
MOTOR2: J1.6, U1.64 (PC7)
MOTOR3: J1.7, U1.65 (PC8)
MOTOR4: J1.8, U1.66 (PC9)
NRST: C13.1, J7.4, U1.14 (NRST)
unnamed: C27.1, U6.10 (CAP)
unnamed: C32.1, C33.1, C34.1, F1.2, FLG05.1, R18.1, U9.3 (VIN)
unnamed: C35.1, U9.7 (BOOT)
unnamed: C35.2, L1.1, U9.8 (SW)
unnamed: C39.2, R31.2, R32.1, U8.5 (FB)
unnamed: C51.1, U13.11 (SS)
unnamed: L2.1, U8.3 (SW)
unnamed: R18.2, R19.1, U9.2 (EN)
unnamed: R20.1, U9.4 (RT/SYNC)
unnamed: R21.2, R22.1, U9.5 (FB)
unnamed: R23.2, R24.1, U13.6 (PR1)
unnamed: R24.2, R25.1, U13.5 (OV1)
unnamed: R26.2, R27.1, U13.4 (OV2)
unnamed: R28.1, U13.10 (ILIM)
OSC_IN: R1.2, U1.12 (PH0)
OSC_RAW: R1.1, Y2.3 (OUT)
PWR_SRC_PRI: R30.2, U1.1 (PE2), U13.9 (ST)
SD_CS: J11.2 (CD/DAT3), R36.2, U1.41 (PE11)
SD_DAT1: J11.8 (DAT1), R39.2
SD_DAT2: J11.1 (DAT2), R35.2
SD_DETECT: J11.9 (DET_B), R40.2, U1.45 (PE15)
SD_PWR_EN: R41.2, U1.40 (PE10), U12.3 (ON)
SD_VDD: C53.2, C54.2, J11.4 (VDD), R35.1, R36.1, R37.1, R38.1, R39.1, U12.5 (QOD), U12.6 (VOUT)
SPI1_MISO: U1.30 (PA6), U2.1 (AP_SDO/AP_AD0)
SPI1_MOSI: U1.31 (PA7), U2.14 (AP_SDI/AP_SDA)
SPI1_SCK: U1.29 (PA5), U2.13 (AP_SCLK/AP_SCL)
SPI2_MISO: U1.53 (PB14), U7.10 (SDO2), U7.15 (SDO1)
SPI2_MOSI: U1.54 (PB15), U7.9 (SDX)
SPI2_SCK: U1.52 (PB13), U7.8 (SCX)
SPI4_MISO: J11.7 (DAT0), R38.2, U1.43 (PE13)
SPI4_MOSI: J11.3 (CMD), R37.2, U1.44 (PE14)
SPI4_SCK: J11.5 (CLK), U1.42 (PE12)
SWCLK: J7.3, U1.76 (PA14(JTCK)
SWDIO: J7.2, U1.72 (PA13(JTMS)
SWO: U1.89 (PB3(JTDO)
UART4_RX: U1.79 (PC11)
UART4_TX: J4.4, U1.78 (PC10)
UART5_RX: J1.4, U1.83 (PD2)
USART1_RX: J2.3, U1.69 (PA10)
USART1_TX: J2.4, U1.68 (PA9)
USART2_RX: J3.4, U1.25 (PA3)
USART2_TX: J3.3, U1.24 (PA2)
USART3_RX: J6.4, U1.56 (PD9)
USART3_TX: J6.3, U1.55 (PD8)
USBC_CC1: J10.A5 (CC1), R9.1
USBC_CC2: J10.B5 (CC2), R10.1
USBC_DM: J10.A7 (D-), J10.B7 (D-), U5.1 (I/O1)
USBC_DP: J10.A6 (D+), J10.B6 (D+), U5.3 (I/O2)
USB_DM: U1.70 (PA11), U5.6 (I/O1)
USB_DP: U1.71 (PA12), U5.4 (I/O2)
VBAT_RAW: D3.1 (K), F1.1, J1.1, J4.1, R6.1
VBAT_SENSE: C25.1, R6.2, R7.1, U1.15 (PC0)
VBUS: C24.1, D2.2 (A), J10.A4 (VBUS), J10.A9 (VBUS), J10.B4 (VBUS), J10.B9 (VBUS), U5.5 (VBUS)
VCAP1: C11.1, U1.48 (VCAP)
VCAP2: C12.1, U1.73 (VCAP)
VIDEO: J4.3, J5.3

Notes on the sheet:
VBAT_RAW comes from the ESC connector (J1). D3 clamps load-dump spikes from the ESC (6S max, ~42 V clamp).
Off-board: 1000 uF 35 V low-ESR bulk cap at the ESC battery pads.
POWER: BATTERY INPUT PROTECTION
fSW = 400 kHz (R20). VOUT = 1.0 V x (1 + R21/R22) = 5.02 V. EN UVLO: on at 13.8 V, off at 12.1 V (R18/R19).
F1 opens if the buck fails short so VBAT cannot reach 5V_BUCK. D4 clamps 5V_BUCK until F1 clears.
PG is open-drain: BEC_PGOOD to PD3 (EXTI3), pull-up R29.
POWER: 5V BEC (LMR38020, 6S IN)
IN1 = onboard buck (priority), IN2 = J8 external BEC (backup). Switches to IN2 below 4.47 V (R23-R25 on PR1).
OV1 drops the buck above 5.83 V. OV2 drops J8 above 5.86 V. Current limit 2.5 A (R28).
ST (PWR_SRC_PRI, PE2/EXTI2): high = running on buck, low = running on J8 backup. Firmware latches a power-degraded fault.
POWER: 5V FAILOVER MUX (TPS2121)
VOUT = 0.6 V x (1 + R31/R32) = 3.32 V, 2 A. FB1 + C7-C10 isolate +3V3A for VDDA and VREF+.
POWER: 3.3V BUCK + ANALOG RAIL (TLV62569)
One ultra-low-noise LDO per IMU, fed from +5V. EN defaults on (R33/R34). Firmware pulls IMUx_PWR_EN low to power-cycle
a hung IMU.
Before cutting an IMU rail, drive its SPI, CS and INT lines low to avoid back-powering through I/O pins.
POWER: IMU RAILS (2x TPS7A2033)
5.1k CC pull-downs = UFP. D2 lets VBUS feed +5V without back-feeding the battery side.
USB-C (DEVICE, FS)
One 100 nF per VDD/VBAT pin, 100 nF + 1 uF on VDDA and on VREF+, 2.2 uF per VCAP. Place each cap at
its pin.
MCU: STM32H723VGT6
HSE in bypass mode. Clock security system falls back to HSI if Y2 fails.
CLOCK: 8 MHz MEMS OSCILLATOR
SWD on J7. Hold SW1 at reset for the ROM bootloader (USB DFU).
DEBUG & BOOT
SPI1 up to 24 MHz. INT1 on PC4 (EXTI4). INT2/FSYNC/CLKIN on PA8
(TIM1_CH1/MCO1) for an optional 32 kHz CLKIN.
RESV pin 7 must be GND. Pins 2/3/10/11 tied to GND. Powered from +3V3_IMU1.
SENSOR: IMU 1 (ICM-42688-P, SPI1)
SPI2 up to 10 MHz. PS = GND selects SPI. Separate bus, CS and interrupts from
IMU 1 so one fault cannot take out both IMUs. Powered from +3V3_IMU2.
SENSOR: IMU 2 (BMI088, SPI2)
I2C1 address 0x46 (SDO = GND, CSB = VDDIO). R2/R3 are the shared I2C1 pull-
ups. Cover with open-cell foam.
SENSOR: BAROMETER (BMP581, I2C1)
I2C1 address 0x30. C27 is the SET/RESET storage cap.
SENSOR: MAGNETOMETER (MMC5983MA, I2C1)
SPI4: PE12 SCK, PE13 MISO, PE14 MOSI, PE11 CS. SD_DETECT on PE15 (EXTI15), low = card present.
U12 powers the card from +3V3. Firmware pulls SD_PWR_EN (PE10) low to power-cycle a hung card. Data-
line pull-ups go to SD_VDD so they never back-power the card.
SD LOGGER (microSD on SPI4)
VBAT: 11:1 divider, 6S full charge (25.2 V) = 2.29 V at PC0. CURR on PC1.
5V_BUCK and 5V_EXT: 2:1 dividers on PA0 (ADC1_INP16) and PA1 (ADC1_INP17). Place C25/C26/C44/C45 at
the MCU pins.
ADC SENSING (BATTERY, CURRENT, 5V RAILS)
J1 ESC 8-pin JST-SH. J2 ELRS RX, J4 VTX (6S direct), J5 camera, J6 Pico:
JST-SH. J3 GPS: 6-pin JST-GH.
EXTERNAL CONNECTORS
RGB LED is common anode on +3V3, active-low drive from PD12/PE0/PE1. Q1
sinks the 5 V buzzer on J9.
STATUS LED & BUZZER
POWER TREE & HEALTH MONITORING
VBAT_RAW (6S, 25.2 V max) from J1 ESC -> D3 clamp, R6/R7 sense (PC0), J4 VTX
VBAT_RAW -> F1 2 A -> U9 LMR38020 -> 5V_BUCK -> U13 IN1 (priority)
J8 external BEC -> 5V_EXT -> U13 IN2 (backup)
U13 OUT -> +5V -> J2 ELRS, J3 GPS, J5 camera, J6 Pico, J9 buzzer, U8, U10, U11
USB VBUS -> D2 -> +5V (bench power, no battery)
+5V -> U8 TLV62569 -> +3V3 -> MCU, baro, mag, oscillator, LED, U12
+3V3 -> FB1 -> +3V3A -> VDDA, VREF+
+5V -> U10 TPS7A2033 -> +3V3_IMU1 -> ICM-42688-P (U2)
+5V -> U11 TPS7A2033 -> +3V3_IMU2 -> BMI088 (U7)
+3V3 -> U12 TPS22917 -> SD_VDD -> microSD (J11)
Health signals to MCU: BEC_PGOOD (PD3), PWR_SRC_PRI (PE2), 5V_BUCK_SENSE (PA0), 5V_EXT_SENSE (PA1), VBAT_SENSE (PC0), CURR_SENSE (PC1).
Firmware-controlled resets: IMU1_PWR_EN (PE7), IMU2_PWR_EN (PE8), SD_PWR_EN (PE10). All default on through pull-ups.
MCU PIN ASSIGNMENT (U1, LQFP-100)
PIN
NET
BOOT0
NRST
PA0
5V_BUCK_SENSE
PA1
5V_EXT_SENSE
PA2
USART2_TX
PA3
USART2_RX
PA4
IMU1_CS
PA5
SPI1_SCK
PA6
SPI1_MISO
PA7
SPI1_MOSI
PA8
IMU1_INT2
PA9
USART1_TX
PA10
USART1_RX
PA11
USB_DM
PA12
USB_DP
PA13
SWDIO
PA14
SWCLK
PB0
MAG_INT
PB1
BARO_INT
PB3
SWO
PB4
BUZZER_CTRL
PB8
I2C1_SCL
PB9
I2C1_SDA
PB12
IMU2_ACC_CS
PB13
SPI2_SCK
PB14
SPI2_MISO
PB15
SPI2_MOSI
PC0
VBAT_SENSE
PC1
CURR_SENSE
PC4
IMU1_INT1
PC6
MOTOR1
PC7
MOTOR2
PC8
MOTOR3
PC9
MOTOR4
PC10
UART4_TX
PC11
UART4_RX
PD2
UART5_RX
PD3
BEC_PGOOD
PD8
USART3_TX
PD9
USART3_RX
PD10
IMU2_GYR_CS
PD11
IMU2_ACC_INT
PD12
LED_B
PD13
IMU2_GYR_INT
PE0
LED_R
PE1
LED_G
PE2
PWR_SRC_PRI
PE7
IMU1_PWR_EN
PE8
IMU2_PWR_EN
PE10
SD_PWR_EN
PE11
SD_CS
PE12
SPI4_SCK
PE13
SPI4_MISO
PE14
SPI4_MOSI
PE15
SD_DETECT
PH0
OSC_IN
