Ilgneous/RipWing/ripwing/firmware/src/transport.rs

//! Firmware-side inter-task transport.
//!
//! The data *types* that cross task boundaries now live in `ripwing-common`
//! so the host-testable control crate can use them too. This module
//! re-exports them for convenience and adds the one thing that is genuinely
//! firmware-only: the `SeverityFlag` atomic container.
//!
//! Why the flag lives here and not in `common`: it is a concurrency
//! primitive tied to how firmware shares state between RTIC tasks. The pure
//! control logic never touches it — it receives a plain `Severity` value.
//! Keeping the atomic out of `common` keeps `common` free of any
//! synchronization concern.

use core::{sync::atomic::{AtomicU8, AtomicU32, Ordering}};

// Re-export the shared data vocabulary so existing `crate::transport::Foo`
// paths keep working.
// Re-export the shared data vocabulary so existing `crate::transport::Foo`
// paths keep working. Some (ImuSample, RcEvent) are not consumed yet but are
// part of the intended vocabulary; allow the unused-import warning on them.
#[allow(unused_imports)]
pub use ripwing_common::{
    AttitudeSetpoint, ImuSample, MotorCommand, RateSetpoint, RcEvent, Severity, StateEstimate,
};

/// Lock-free severity channel: one atomic byte shared between the anomaly
/// task (writer) and the control task (reader). The control loop reads this
/// on its hot path with a single relaxed load — no lock, no blocking.
pub struct SeverityFlag {
    raw: AtomicU8,
}

impl SeverityFlag {
    pub const fn new() -> Self {
        Self {
            raw: AtomicU8::new(Severity::Nominal as u8),
        }
    }

    /// Writer side (anomaly task). Relaxed is sufficient: this is a status
    /// hint, not a synchronization point guarding other memory.
    #[inline]
    pub fn set(&self, s: Severity) {
        self.raw.store(s as u8, Ordering::Relaxed);
    }

    /// Reader side (control task hot path). Single relaxed load, no lock.
    #[inline]
    pub fn get(&self) -> Severity {
        Severity::from_u8(self.raw.load(Ordering::Relaxed))
    }
}

impl Default for SeverityFlag {
    fn default() -> Self {
        Self::new()
    }
}

/// Per-task iteration counters for bring-up diagnostics.
///
/// Each periodic task increments its counter once per loop. A low-priority
/// diagnostics task samples and clears them every second, so the printed
/// value *is* the task's measured rate in Hz. This turns the rate-monotonic
/// schedule (case study §4.3) from a design assumption into a measurement,
/// with no oscilloscope required.
///
/// Plain atomics rather than RTIC resources: incrementing must be as close
/// to free as possible on the 1 kHz hot paths, and a counter needs no
/// priority-ceiling arbitration.
pub struct TaskCounters {
    pub safety: AtomicU32,
    pub control: AtomicU32,
    pub fusion: AtomicU32,
    pub anomaly: AtomicU32,
    pub logging: AtomicU32,
    pub telemetry: AtomicU32,
    pub secondary: AtomicU32,
}

impl TaskCounters {
    pub const fn new() -> Self {
        Self {
            safety: AtomicU32::new(0),
            control: AtomicU32::new(0),
            fusion: AtomicU32::new(0),
            anomaly: AtomicU32::new(0),
            logging: AtomicU32::new(0),
            telemetry: AtomicU32::new(0),
            secondary: AtomicU32::new(0),
        }
    }

    // Counters in canonical order:
    // [safety, control, fusion, anomaly, logging, telemetry, secondary]
    pub fn snapshot(&self) -> [u32; 7] {
        [
            read(&self.safety),
            read(&self.control),
            read(&self.fusion),
            read(&self.anomaly),
            read(&self.logging),
            read(&self.telemetry),
            read(&self.secondary),
        ]
    }
}

impl Default for TaskCounters {
    fn default() -> Self {
        Self::new()
    }
}

/// Increment a counter. Relaxed: we only need the count to be correct
/// eventually, not to synchronize other memory.
#[inline]
pub fn tick(counter: &AtomicU32) {
    counter.fetch_add(1, Ordering::Relaxed);
}

/// Read a counter without clearing it. Counters are free-running and wrap at
/// 'u32::MAX' (50 days at 1kHz). Several consumers can watch same counter
/// independently. 
#[inline]
pub fn read(counter: &AtomicU32) -> u32 {
    counter.load(Ordering::Relaxed)
}

/// What the sensor chain hands the control task for each sample.
#[derive(Clone, Copy, Debug)]
pub struct ControlTick {
    /// Seconds since the previous sample, measured between the sensor's own
    /// data-ready edges (not assumed from the nominal ODR).
    pub dt: f32,
    /// DWT cycle count at this sample's data-ready edge, for end-to-end
    /// latency measurement.
    pub drdy_cycles: u32,
}

/// Counters and timing for the sensor-driven chain. Atomics for the same
/// reason as `TaskCounters`: written on the hot path, read by diagnostics.
pub struct ImuStats {
    /// Data-ready edges seen.
    pub drdy: AtomicU32,
    /// Edges that arrived while the previous SPI transfer was still in
    /// flight (that sample is lost).
    pub dma_busy: AtomicU32,
    /// Samples that arrived while the estimator or controller was still
    /// working on the previous one. Nonzero means compute exceeds the
    /// sample period.
    pub chain_overruns: AtomicU32,
    /// Frames the driver rejected as invalid.
    pub rejected: AtomicU32,
    /// DMA transfer errors and stuck-transfer recoveries.
    pub bus_errors: AtomicU32,
    /// Raw samples dropped because the log queue was full.
    pub log_drops: AtomicU32,
    /// Raw samples drained by the logging task.
    pub logged: AtomicU32,
    /// Worst data-ready -> motor-command latency since last read [cycles].
    latency_max: AtomicU32,
    /// Most recent data-ready -> motor-command latency [cycles].
    latency_last: AtomicU32,
}

impl ImuStats {
    pub const fn new() -> Self {
        Self {
            drdy: AtomicU32::new(0),
            dma_busy: AtomicU32::new(0),
            chain_overruns: AtomicU32::new(0),
            rejected: AtomicU32::new(0),
            bus_errors: AtomicU32::new(0),
            log_drops: AtomicU32::new(0),
            logged: AtomicU32::new(0),
            latency_max: AtomicU32::new(0),
            latency_last: AtomicU32::new(0),
        }
    }

    #[inline]
    pub fn record_latency(&self, cycles: u32) {
        self.latency_last.store(cycles, Ordering::Relaxed);
        self.latency_max.fetch_max(cycles, Ordering::Relaxed);
    }

    /// (worst since the previous call, most recent), in cycles. Resets the
    /// worst-case so each report covers one window.
    pub fn take_latency(&self) -> (u32, u32) {
        (
            self.latency_max.swap(0, Ordering::Relaxed),
            self.latency_last.load(Ordering::Relaxed),
        )
    }
}

impl Default for ImuStats {
    fn default() -> Self {
        Self::new()
    }
}
