Ilgneous/RipWing/ripwing/crates/control/src/attitude.rs

//! Attitude rate controller: three PID axes (roll, pitch, yaw) plus mixing.
//!
//! The inner stage of the cascade and the concrete `Controller` the
//! firmware runs. It is a *rate* controller: it drives the body angular
//! rates toward the commanded rates. The outer attitude loop
//! ([`crate::AttitudeAngleController`]) produces those commanded rates
//! from attitude angles.

use crate::controller::Controller;
use crate::mixer;
use crate::pid::{Pid, PidConfig};
use ripwing_common::{MotorCommand, RateSetpoint, Severity, StateEstimate};

/// Gains for all three axes, straight from the simulator's optimizer.
#[derive(Clone, Copy, Debug)]
pub struct AttitudeGains {
    pub roll: PidConfig,
    pub pitch: PidConfig,
    pub yaw: PidConfig,
}

/// Rate controller: one PID per body axis, feeding the mixer.
pub struct AttitudeRateController {
    roll: Pid,
    pitch: Pid,
    yaw: Pid,
    /// Base thrust passthrough is handled in the mixer; kept here for
    /// possible thrust shaping under degraded severity.
    _reserved: (),
}

impl AttitudeRateController {
    pub fn new(gains: AttitudeGains) -> Self {
        Self {
            roll: Pid::new(gains.roll),
            pitch: Pid::new(gains.pitch),
            yaw: Pid::new(gains.yaw),
            _reserved: (),
        }
    }
}

impl Controller for AttitudeRateController {
    fn step(
        &mut self,
        state: &StateEstimate,
        rate_cmd: &RateSetpoint,
        severity: Severity,
        dt: f32,
    ) -> MotorCommand {
        // Commanded rates come from the rate setpoint; measured rates from
        // the estimator. Now that the setpoint type is explicitly a
        // RateSetpoint, `.rates` is unambiguous — no more overloaded field.
        let roll_out = self.roll.update(rate_cmd.rates[0], state.body_rates[0], dt);
        let pitch_out = self.pitch.update(rate_cmd.rates[1], state.body_rates[1], dt);
        let yaw_out = self.yaw.update(rate_cmd.rates[2], state.body_rates[2], dt);

        // Optional conservative response under a Critical anomaly: scale
        // thrust back so a suspected fault has less energy to work with.
        // The ML only *gates* this deterministic action; it never commands
        // motors directly (§7.6).
        let thrust = match severity {
            Severity::Critical => rate_cmd.thrust * 0.8,
            _ => rate_cmd.thrust,
        };

        mixer::mix_quad_x(thrust, roll_out, pitch_out, yaw_out)
    }

    fn reset(&mut self) {
        self.roll.reset();
        self.pitch.reset();
        self.yaw.reset();
    }
}
