Ilgneous/RipWing/(commit log)

2026-07-23 fix: diagnostics.py path logic
    [diagnostics.py]
2026-07-26 Schematic preview
2026-07-29 feat: sensor filter
2026-07-29 fix: used board.rs consts
    [controller.rs, main.rs]
2026-08-12 fix: timer semantics. First flash!
    [main.rs]
2026-08-16 schematic done (rage baited nerd)
    [Ripwing.kicad_sch]
2026-10-29 IMU and Capacitor updates
2026-11-09 Update schematic and organization
2026-11-10 QuadSim: 7" props, rotor-reaction sign fix, yaw tuning stage
    Plant
    - Switch the airframe to 7-inch props, with coefficients derived from prop
    data (C_T 0.10, C_P 0.045): k_f 3.10e-6, k_m 3.95e-8, J_r 2.75e-5,
    R 0.0889 m, tau_m 35 ms. Hover is about 9,300 rpm.
    - Finish the half-done attribute rename (thrust_coeff, drag_torque_coeff,
    max/hover_motor_speed, motor_speed_hist). The 10-DOF model already used
    the new names and crashed against the base class.
    - Fix the rotor angular momentum and spin-up reaction torque signs. Yaw
    corrections used to kick the wrong way, which caused the yaw wander. Add
    a regression test, and fix the flapping test's setpoint keys (it had
    never passed). 5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
2026-11-10 firmware: fly QuadSim's tuned gains; sensor-driven loop, FLU mixer fix
    Gains
    - New crates/control/src/gains.rs: QuadSim's tuned roll/pitch and yaw
    rate gains, converted to mixer units for the 1 kHz loop (/13.52 N.m
    roll/pitch, /1.083 N.m yaw; D filter alpha 0.159 at 30 Hz). The
    attitude P gains are kept for the coming outer loop. The firmware now
    builds its AttitudeRateController from these, replacing the placeholders.
    - tests/quadsim_firmware_gains.rs recomputes them from the exported tune
    and fails if they drift.
    Mixer
    - Fix mix_quad_x signs for the body FLU frame used by the IMU, the
    estimator and QuadSim. The FRD signs gave positive feedback on pitch
    and yaw.
    QuadSim cros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
2026-11-10 control: outer attitude loop, wired into the firmware
    The tuned attitude P gains in gains.rs had no stage using them. Add one.
    - New AttitudeAngleController (crates/control/src/angle.rs) behind a new
    AttitudeLoop trait. It maps AttitudeSetpoint to RateSetpoint with
    QuadSim's law, k_att * (angle_d - angle), wrapping the heading error to
    [-pi, pi) so it turns the short way. Two additions:
    - a per-axis rate-demand clamp (gains::MAX_RATE: 6, 6, 4 rad/s);
    - tilt-compensated thrust, floored at cos 0.5 like QuadSim.
    - Firmware: the control task reads a shared AttitudeSetpoint (level, zero
    thrust until the RC driver writes it) and runs the outer loop, then the
    rate loop, every IMU sam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
2026-11-10 sensors: BMI088, BMP581 and MMC5983MA drivers, polled by the firmware
    Drivers for the H723 PCB's secondary sensors, wired into the BlackPill
    firmware on the PCB's own buses and pins.
    crates/sensors (new, no_std, embedded-hal 1.0, no HAL)
    - BMI088 (IMU2, SPI). Handles the accel die's quirks: I2C mode until a
    CS rising edge, a dummy byte on reads, and suspend-mode write spacing.
    Config registers are read back and the error register is checked.
    - BMP581 (I2C 0x46). Soft reset with an NVM/POR check; 50 Hz, OSR x16,
    IIR routed to the outputs. Init fails if the chip's odr_is_valid
    rejects the ODR/OSR combination.
    - MMC5983MA (I2C 0x30). Bridge offset measured with SET/RESET and removed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
2026-11-10 estimation: fuse magnetometer (heading) and barometer (altitude)
    Heading
    - update_mag rotates the MMC5983MA field into the world frame with the
    current attitude (tilt compensation). It corrects heading only, with a
    rotation about the world vertical, so a disturbed field can never move
    roll or pitch.
    - The first accepted reading snaps heading at boot. After that the
    correction is rate-limited (tau = 1/kp = 5 s), so a magnetometer that
    comes back mid-flight cannot jerk the heading loop.
    - Readings are gated on field strength: the Earth-plausible range
    20-70 uT, and +/-25 % of the referenced strength. The reference is
    re-taken after 2 s of continuous rejection.
    - Declination and h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
2026-11-10 safety: real battery voltage/current ADC reads; low battery warns, never cuts
    Replaces the 12.0 V placeholder fed to the safety monitor.
    Policy change
    - Low battery now refuses arming, but in flight it is a warning
    (Low/Critical), never a motor cut. With no auto-land a cut is a crash.
    The old instantaneous 10.5 V floor would also have tripped on normal
    throttle sag once fed real readings.
    - SafetyInputs carries a BatteryStatus instead of raw volts.
    SafetyLimits::min_battery_volts moves to BatteryConfig.
    Battery monitor (crates/safety/src/battery.rs)
    - Levels are judged on a sag-filtered voltage (tau 1 s) that must stay
    below its threshold for 2 s. Low is 3.5 V/cell, Critical 3.3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
